kuellenberg/7-Segment-RGB-Clock/clock.png

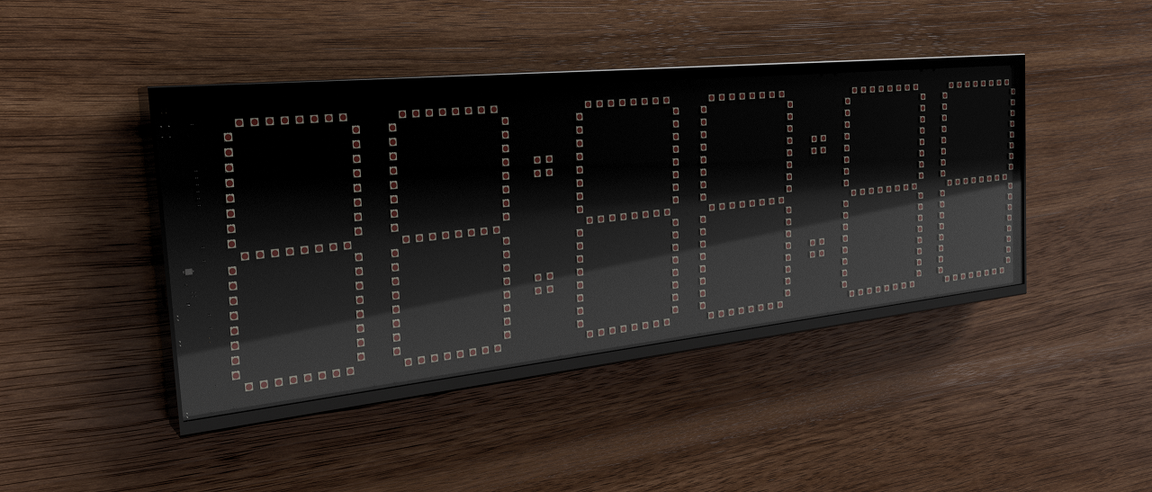
clock.png
