kuellenberg/7-Segment-RGB-Clock/Controller Rev. B/Room v2.png

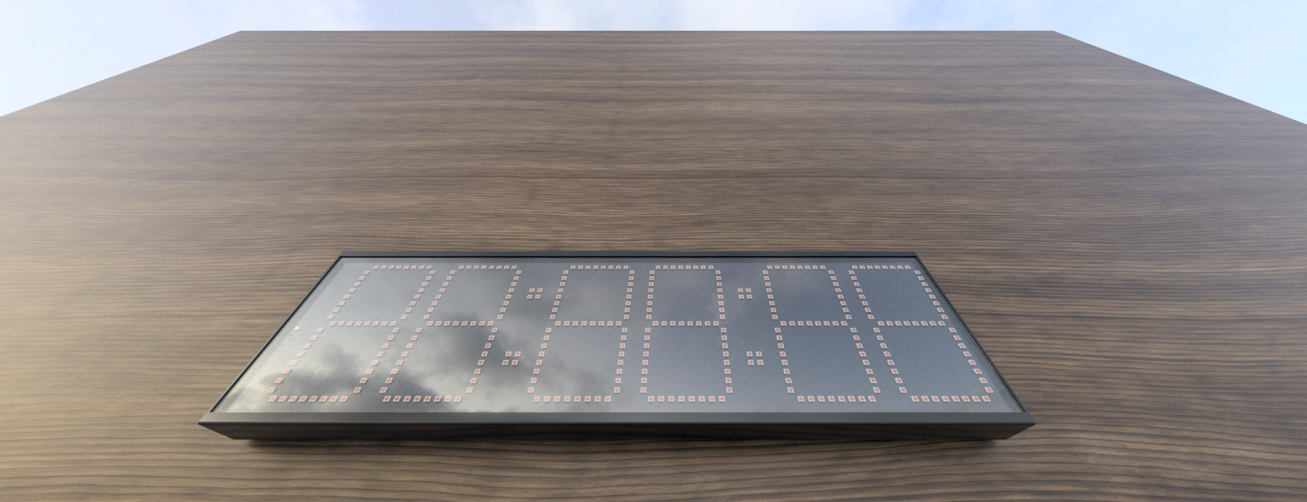
Controller Rev. B/Room v2.png
