kuellenberg/7-Segment-RGB-Clock/RS Components.xls

Order | Stückzahl | RS Components | Mouser | Herst.- Nr. | Hersteller | Beschreibung
y | 2 | 131-0271 |  | ATMEGA328P-AU | Microchip | 8-Bit Mikrocontroller - MCU 32KB In-system Flash 20MHz 1.8V-5.5V
y | 2 | 219-6096 |  | 0154001.DR | Littelfuse | Sicherungen zur Aufbaumontage Fuseblock w/ fuse 1A OMNI BLOK 154
y | 2 | 219-6125 |  | 0154004.DRT | Littelfuse | Sicherungen zur Aufbaumontage Fuseblock w/ fuse 4A OMNI BLOK 154T
n | 2 | 787-4218 |  | 1812L050PR | Littelfuse | Rückstellbare Sicherungen - PPTC 1812 15V .5A
n | 2 | 526-381 |  | SN74AHC1G14DBVR | Texas Instruments | Inverter Single Schmitt-Trgr
y | 4 | 715-1174 |  | UUR1A101MCL1GS | Nichicon | Alu-Elektrolytkondensatoren - SMD 10volts 100uF 20% AEC-Q200
y | 2 | 172-5271 |  | 61729-0011BLF | FCI / Amphenol | USB-Stecker USB
y | 2 | 740-8798 |  | RN73H1JTTD1000F100 | KOA Speer | Dünnfilmwiderstände - SMD 100Ohm,0603,1%,10ppm ,100mW,75V
y | 16 | 213-2266 |  | RN73H1JTTD1001F100 | KOA Speer | Dünnfilmwiderstände - SMD 1kOhm,0603,1%,10ppm, 100mW,75V
n | 8 | 679-0484 |  | RN73H1JTTD4701F100 | KOA Speer | Dünnfilmwiderstände - SMD 4.7kOhm,0603,1%,10pp m,100mW,75V
n | 4 | 678-9667 |  | RN73H1JTTD1002F50 | KOA Speer | Dünnfilmwiderstände - SMD 10kOhm,0603,1%,50ppm ,100mW,75V
y | 4 | 569-287 |  | EMVE250ADA331MJA0G | United Chemi-Con (UCC) | Alu-Elektrolytkondensatoren - SMD 25volts 330uF 10X10
y | 4 | 715-1433 |  | EEE-FK1K4R7P | Panasonic | Alu-Elektrolytkondensatoren - SMD 4.7UF 80V FK SMD
y | 2 | 191-3543 |  | DS3231M+TRL | Maxim Integrated | Echtzeituhr 5ppm, I C Real-Time Clock
y | 8 | 839-2950 |  | 885012206089 | Wurth Elektronik | Kondensator aus mehreren Keramikschichten MLCC - SMD/SMT WCAP-CSGP 0.01uF 0603 10% 50V MLCC
y | 2 | 181-4072 |  | 885012207092 | Wurth Elektronik | Kondensator aus mehreren Keramikschichten MLCC - SMD/SMT WCAP-CSGP 0.01uF 0805 10% 50V MLCC
y | 2 | 124-3361 |  | SFH 2440 | Osram Opto Semiconductor | Fotodioden PHOTODIODE
y | 2 | 180-7990 |  | SQ2309ES-T1_GE3 | Vishay | MOSFET 60V -1.7A 2W AEC-Q101 Qualified
y | 4 | 710-3339 |  | SI4435FDY-T1-GE3 | Vishay | MOSFET -30V Vds 20V Vgs SO-8
y | 2 | 135-6149 |  | FC0H105ZFTBR44-SS | KEMET | Superkondensatoren/Ultra-Kondensatoren 5.5V 1F -20/+80% Tape Width=44mm
y | 2 | 702-7305 | !!!!!!!!!!!!!! | CSTNE16M0V53Z000R0 | Murata | Resonatoren 16.0000MHz 15pF SMD CHP Resntr Wide Temp
y | 16 |  | 855-M20-8890845 | M20-8890845 | Harwin | Sockel & Kabelgehäuse 8 WAY SIL HORIZ SMT P/HDR
y | 10 | 692-0979 |  | LTST-C191KFKT | Lite-On | Standard-LEDs - SMD Orange Clear 605nm
y | 4 | 692-1051 |  | LTST-C193TBKT-5A | Lite-On | Standard-LEDs - SMD Blue 470nm 28mcd 20mA
y | 4 | 688-0492 |  | MBR130T1G | ON Semiconductor | Schottky Dioden & Gleichrichter 1A 30V
y | 2 | 406-580 |  | FT232RL-REEL | FTDI | USB-IC-Schnittstelle USB to Serial UART Enhanced IC SSOP-28
y | 2 |  | 926-LMV301MGX/NOPB | LMV301MGX/NOPB | Texas Instruments | Operationsverstärker
y | 6 | 724-2728 |  | LBR2012T100K | Taiyo Yuden | Festinduktivitäten 0805 10uH 468mOhms +/-10%Tol 150mA
n | 2 | 723-4972 |  | TMK107B7105MA-T | Taiyo Yuden | Kondensator aus mehreren Keramikschichten MLCC - SMD/SMT 0603 25V 1.0uF 20% X7R
n | 42 | 788-2985 |  | CGA3E2X7R1H104K080AA | TDK | Kondensator aus mehreren Keramikschichten MLCC - SMD/SMT CGA 0603 50V 0.1uF X7R 10% AEC-Q200
y | 12 | 788-3017 |  | GRM21BR71A106KA73K | Murata | Kondensator aus mehreren Keramikschichten MLCC - SMD/SMT 10UF 10V 10% 0805
y | 24 | 568-525 |  | EEE-HA1E331UP | Panasonic | Alu-Elektrolytkondensatoren - SMD 330UF 25V ELECT HA SMD
y | 12 | 171-4263 |  | SMAJ6.0CA | Bourns | ESD-Entstörer/TVS-Dioden 6volts 800/1600uA 38.8 Amps Bi-Dir
y | 24 | 187-1547 |  | AQ05C-01FTG | Littelfuse | ESD-Entstörer/TVS-Dioden 450W 5V BI AEC-Q101
y | 12 |  | 855-M20-7910842R | M20-7910842R | Harwin | Sockel & Kabelgehäuse 8 WAY SIL HORIZ SMT SKT T&R
y | 12 | 812-3353 |  | CRCW08050000Z0EAC | Vishay | Dickfilmwiderstände - SMD 1/8Watt 0ohms Commercial Use
y | 96 | 123-1691 |  | RT0805DRE071K58L | Yageo | Dünnfilmwiderstände - SMD
y | 12 |  | 595-TLC5952DAP | TLC5952DAP | Texas Instruments | LED-Anzeigetreiber 24-Channel Constant Current LED Drvr
y | 6 | 121-8344 |  | SN74LS244DWR | Texas Instruments | Puffer u. Leitungstreiber Tri-State Octal
y | 2 | 211-8030 |  | B57364S0509M000 |  | ntc
y | 1 | 493-2838 |  | Schurter 4300.5054
y | 1 | 533-4825 |  | Lumberg KFV 30
y | 1 | 533-6720 |  | Lumberg SV 30
y | 1 | 740-6155 |  | Lumberg WSV 30
y | 1 | 671-8978 |  |  |  | Ringkerntransformator, 80VA, Primär 230V ac / Sekundär 2 x 12V ac, 3.333A
y | 1 | 189-8189 |  | SK85-50-SA |  | Fischer Elektronik Kühlkörper 1.3K/W, 50mm x 160mm x 40mm, für Universelle rechteckige Alu
y | 1 | Conrad |  |  |  | Bopla ULTRAMAS UM 52011 L-50
