kuellenberg/7-Segment-RGB-Clock/BOM - Rev. A.xlsx

Sheet: Controller
Ref | Qnty | Spalte1 | Value | Cmp name | Footprint | Description | Mouser
C1, C2 | 2 | 4 | 330uF | CP_Small | Capacitor_SMD:CP_Elec_10x10 | Polarized capacitor, small symbol | …
C3 | 1 | 2 | 10nF | C_Small | Capacitor_SMD:C_0805_2012Metric | Unpolarized capacitor, small symbol | 710-885012207092
C4, C5 | 2 | 4 | 100uF | CP_Small | Capacitor_SMD:C_Elec_6.3x5.8 | Polarized capacitor, small symbol | 647-UUR1A101MCL1GS
C11, C9 | 2 | 4 | 4u7 | CP_Small | Capacitor_SMD:C_Elec_4x5.8 | Polarized capacitor, small symbol | 647-UUA1V4R7MCL1GS
C13, C20, C7, C8, C18, C15, C16, C12, C10 | 9 | 18 | 100nF | C_Small | Capacitor_SMD:C_0603_1608Metric | Unpolarized capacitor, small symbol | 810-CGA3E2X7R1H104K
C19, C23, C14, C17, C6 | 5 | 10 | 10nF | C_Small | Capacitor_SMD:C_0603_1608Metric | Unpolarized capacitor, small symbol | 710-885012206089
C22, C25, C21, C24 | 4 | 8 | 100n | C_Small | Capacitor_SMD:C_0603_1608Metric | Unpolarized capacitor, small symbol | …
C26 | 1 | 2 | 1F | CP | ak:FC0H105ZFTBR44 | Polarized capacitor | out of stock
D1, D2 | 2 | 4 | BLUE | LED | LED_SMD:LED_0603_1608Metric | Light emitting diode | 859-LTSTC193TBKT5A
D3, D9 | 2 | 4 | SS1P3L | D | Diode_SMD:D_SOD-123 | Diode | 863-MBR130T1G
D4 | 1 | 2 | ORANGE | LED | LED_SMD:LED_0603_1608Metric | Light emitting diode | 859-LTST-C191KFKT
D5 | 1 | 2 | GREEN | LED | LED_SMD:LED_0603_1608Metric | Light emitting diode | …
D6 | 1 | 2 | RX ORANGE | LED | LED_SMD:LED_0603_1608Metric | Light emitting diode | …
D7 | 1 | 2 | TX GREEN | LED | LED_SMD:LED_0603_1608Metric | Light emitting diode | 859-LTST-C190KGKT
D8 | 1 | 2 | RED | LED | LED_SMD:LED_0603_1608Metric | Light emitting diode | 859-LTST-C190KRKT
F1 | 1 | 2 | 4A | Fuse | ak:Fuseholder_SMD_Littelfuse_154 | Fuse | 576-0154004.DRT
F2 | 1 | 2 | 1A | Fuse | ak:Fuseholder_SMD_Littelfuse_154 | Fuse | 576-0154001.DR
F3 | 1 | 2 | 500mA | Polyfuse | Fuse:Fuse_1812_4532Metric | Resettable fuse, polymeric positive temperature coefficient | 576-1812L050PR
F4 | 1 | 2 | MF-MSMF050-2 500mA | Polyfuse | Fuse:Fuse_1812_4532Metric | Resettable fuse, polymeric positive temperature coefficient | …
J1 | 1 | 2 | CON_TLC | Conn_02x04_Odd_Even | ak:HARWIN_M20-8890845 | Generic connector, double row, 02x04, odd/even pin numbering scheme (row 1 odd numbers, row 2 even numbers), script generated (kicad-library-utils/schlib/autogen/connector/) | …
J2 | 1 | 2 | CON_15V | Conn_01x02 | Connector_JST:JST_XH_B2B-XH-A_1x02_P2.50mm_Vertical | Generic connector, single row, 01x02, script generated (kicad-library-utils/schlib/autogen/connector/) | …
J3 | 1 | 2 | CON_ICSP | Conn_02x03_Odd_Even | Connector_IDC:IDC-Header_2x03_P2.54mm_Vertical | Generic connector, double row, 02x03, odd/even pin numbering scheme (row 1 odd numbers, row 2 even numbers), script generated (kicad-library-utils/schlib/autogen/connector/) | …
J4 | 1 | 2 | DC out | Conn_02x04_Top_Bottom | ak:HARWIN_M20-8890845 | Generic connector, double row, 02x04, top/bottom pin numbering scheme (row 1: 1...pins_per_row, row2: pins_per_row+1 ... num_pins), script generated (kicad-library-utils/schlib/autogen/connector/) | …
J5 | 1 | 2 | CON_5V | Conn_01x02 | Connector_JST:JST_XH_B2B-XH-A_1x02_P2.50mm_Vertical | Generic connector, single row, 01x02, script generated (kicad-library-utils/schlib/autogen/connector/) | …
J6 | 1 | 2 | CON_5V_AUX | Conn_01x02 | Connector_JST:JST_XH_B2B-XH-A_1x02_P2.50mm_Vertical | Generic connector, single row, 01x02, script generated (kicad-library-utils/schlib/autogen/connector/) | …
J7 | 1 | 2 | CON_USB_A | USB_A | ak:UJ2-BV-1-TH | USB Type A connector | 530-SS-52300-002
L3, L2, L1 | 3 | 6 | 10uH | L_Small | Inductor_SMD:L_0805_2012Metric | Inductor, small symbol | 963-LBR2012T100K
Q1, Q2 | 2 | 4 | SI4435FDY | Q_PMOS_SSSGDDDD-ak | Package_SO:SO-8_5.3x6.2mm_P1.27mm |  | 78-SI4435FDY-T1-GE3
Q3 | 1 | 2 | SQ2309ES | Q_PMOS_GSD | Package_TO_SOT_SMD:SOT-23 | P-MOSFET transistor, gate/source/drain | SQ2309ES-T1_GE3
R5, R6, R7, R4, R3, R1, R2 | 7 | 14 | 1k | R_Small | Resistor_SMD:R_0603_1608Metric | Resistor, small symbol | 279-CRGP0603F1K0
R9, R8 | 2 | 4 | 4k7 | R_Small | Resistor_SMD:R_0603_1608Metric | Resistor, small symbol | 755-SFR03EZPF4701
R10 | 1 | 2 | LDR07 | LDR07 | OptoDevice:R_LDR_5.1x4.3mm_P3.4mm_Vertical | light dependent resistor | …
R12, R11 | 2 | 4 | 10k | R_Small | Resistor_SMD:R_0603_1608Metric | Resistor, small symbol | 603-RC0603FR-0710KL
R13 | 1 | 2 | 330R | R_Small | Resistor_SMD:R_0603_1608Metric | Resistor, small symbol | 71-CRCW0603330RFKEAC
R14 | 1 | 2 | 100R | R_Small | Resistor_SMD:R_0603_1608Metric | Resistor, small symbol | 603-AC0603FR-13100RL
R15 | 1 | 2 | 47k | R_Small | Resistor_SMD:R_0603_1608Metric | Resistor, small symbol | 71-CRCW060347K0FKEAC
SW1 | 1 | 2 | SW_Push | SW_Push | Button_Switch_THT:SW_PUSH_6mm | Push button switch, generic, two pins | …
U1 | 1 | 2 | FT232RL | FT232RL | Package_SO:SSOP-28_5.3x10.2mm_P0.65mm | USB to Serial Interface, SSOP-28 | 895-FT232RL
U2 | 1 | 2 | ATmega328P-AU | ATmega328P-AU-ak | Package_QFP:TQFP-32_7x7mm_P0.8mm |  | 556-ATMEGA328P-AU
U3 | 1 | 2 | DS3231M | DS3231M | Package_SO:SOIC-16W_7.5x10.3mm_P1.27mm | Extremely Accurate I2C-Integrated RTC/TCXO/Crystal SOIC-16 | 700-DS3231M+TRL
U4 | 1 | 2 | 74AHC1G14 | 74AHC1G14 | Package_TO_SOT_SMD:SOT-23-5 |  | 595-SN74AHC1G14DBVR
U5 | 1 | 2 | MCP6001-OT | MCP6001-OT | Package_TO_SOT_SMD:SOT-23-5 | 1MHz, Low-Power Op Amp, SOT-23-5 | 579-MCP6001T-I/OT
U6 | 1 | 2 | MCP4012-xxxxCH | MCP4012-xxxxCH | Package_TO_SOT_SMD:SOT-23-6 | Low-Cost 64-Step Volatile Digital Potentiometer | 579-MCP4012T-503E/CH
Y1 | 1 | 2 | 16MHz | Resonator_Small | ak:CSTNE | Three pin ceramic resonator, small symbol | 81-CSTNE16M0V53Z000R

Sheet: Digit+Colon
Ref | Qnty | Spalte1 | Value | Cmp name | Footprint | Description | Mouser
C1, C2, C7, C10, C11, C9, C8 | 7 | 91 | 100n | C_Small | Capacitor_SMD:C_0805_2012Metric | Unpolarized capacitor, small symbol | 810-CGA3E2X7R1H104K
C4, C3, C5, C6 | 4 | 52 | 330uF | CP_Small | Capacitor_SMD:C_Elec_8x10.2 | Polarized capacitor, small symbol | 667-EEE-HA1E331UP
C12, C13 | 2 | 26 | 10uF | C_Small | Capacitor_SMD:C_0805_2012Metric | Unpolarized capacitor, small symbol
D25, D26, D27, D28, D48, D47, D46, D45, D40, D39, D38, D37, D32, D31, D30, D24, D23, D22, D21, D16, D15, D14, D13, D8, D7, D6, D5, D29, D4, D3, D2, D1, D36, D35, D34, D33, D53, D54, D55, D56, D41, D42, D43, D44, D12, D11, D10, D9, D20, D19, D18, D17, D52, D51, D50, D49, D70, D68, D66, D64, D69, D67, D65, D63 | 64 | 832 | LED_RGB | LED_BGR | LED_SMD:LED_RGB_5050-6 | RGB LED, 6 pin package
D57, D62 | 2 | 26 | D_TVS | D_TVS | Diode_SMD:D_SMA | Bidirectional transient-voltage-suppression diode
D60, D61, D59, D58 | 4 | 52 | 5V | D_TVS | Diode_SMD:D_SOD-323 | Bidirectional transient-voltage-suppression diode
J1 | 1 | 13 | DC IN | Conn_02x04_Top_Bottom | ak:HARWIN_M20-8890845 | Generic connector, double row, 02x04, top/bottom pin numbering scheme (row 1: 1...pins_per_row, row2: pins_per_row+1 ... num_pins), script generated (kicad-library-utils/schlib/autogen/connector/)
J2 | 1 | 13 | DC OUT | Conn_02x04_Top_Bottom | ak:HARWIN_M20-7910842R | Generic connector, double row, 02x04, top/bottom pin numbering scheme (row 1: 1...pins_per_row, row2: pins_per_row+1 ... num_pins), script generated (kicad-library-utils/schlib/autogen/connector/)
J3 | 1 | 13 | Signal in | Conn_02x04_Odd_Even | ak:HARWIN_M20-7910842R | Generic connector, double row, 02x04, odd/even pin numbering scheme (row 1 odd numbers, row 2 even numbers), script generated (kicad-library-utils/schlib/autogen/connector/)
J4 | 1 | 13 | Signal out | Conn_02x04_Odd_Even | ak:HARWIN_M20-8890845 | Generic connector, double row, 02x04, odd/even pin numbering scheme (row 1 odd numbers, row 2 even numbers), script generated (kicad-library-utils/schlib/autogen/connector/)
JP1, JP2, JP3, JP4 | 4 | 52 | SolderJumper_2_Open | SolderJumper_2_Open | Jumper:SolderJumper-2_P1.3mm_Open_TrianglePad1.0x1.5mm | Solder Jumper, 2-pole, open
R1, R2, R3, R4, R5, R6, R7, R8, R9, R10, R12, R13, R14, R15, R16, R11, R18, R17 | 18 | 234 | TBD | R_Small | Resistor_SMD:R_0805_2012Metric | Resistor, small symbol | 652-CR0805FX-56R0ELF
U1, U2 | 2 | 26 | TLC5952 | TLC5952 | Package_SO:HTSSOP-32-1EP_6.1x11mm_P0.65mm_EP5.2x11mm_Mask4.11x4.36mm_ThermalVias
U3 | 1 | 13 | 74LS244 | 74LS244 | Package_SO:SO-20_12.8x7.5mm_P1.27mm | 8-bit Bus Buffer 3-State outputs
