kuellenberg/7-Segment-RGB-Clock/Datasheets/Arduino Nano 3.1 BOM.xlsx

 |  | Arduino Nano |  |  |  | v3.1
Item | Quantity | Reference | Part | Mfg P/N | Size | P/N | Feeder LOC | Feeder LOC F/O
1 | 5 | C1,C3,C4,C7,C9 | CAP 0.1uF +/- 5% 50V Ceramic | 08055C104KAT2A | 0805 | C601 (51045) | R12 | F32
2 | 1 | C2 | CAP CERAMIC 10UF 16V -20% +80% Y5V | 08055C104KAT2A | 1206 | C553 (10601) | F32 | F41
3 | 1 | D1 | Diode, Schottky 0.5A 20V | MBR0520LT1G | SOD-123 | C107 (15201) | F41 | F36
4 | 1 | J1,J2 | Headers, 36PS 1 Row |  | PTH
5 | 1 | J4 | Connector, Mini-B Recept Rt. Angle
6 | 1 | J5 | Headers, 72PS 2 Rows |  | PTH
7 | 1 | LD1 | LED, RED 20mA 624nm 42mcd 140deg | EC04-0805QRC/E-AV | 0805 | C101 (2016) | F34 | F34
8 | 1 | LD2 | LED, GREEN 2.1V 20mA 571nm 10mcd 140deg | 17-21SYGC/S530-E2/TR8 | 0805 | C102 (2013) | F35 | F35
9 | 1 | LD3 | LED, YELLOW 2.0V 20mA 589nm 43mcd 140deg | 0805UYC/E-AV | 0805 | C103 (2014) | F31 | F31
10 | 1 | LD4 | LED, Super Bright BLUE 80mcd 470nm 110degree | 17-21SUBHC/S530-A2/TR8 | 0805 | C100 (2015) | F30 | F30
11 | 1 | R1 | Resistor Pack, 1K +/-5% 62.5mW 4RES SMD | YC164-JR-071KL |  | C108 (16407) | F37 | F37
12 | 1 | R2 | Resistor Pack, 680 +/-5% 62.5mW 4RES SMD | YC164-JR-07680RL |  | C109 (16408) | F45 | F35
13 | 1 | SW1 | Switch, Momentary Tact SPST 150gf 3.0x2.5mm | SKRKAEE010
14 | 1 | U1 | IC, Microcontroller ATMEGA328 RISC 32kB Flash, 0.5kB EEPROM, 23 I/O Pins | ATMEGA328P-AUR
15 | 1 | U2 | IC, USB to SERIAL UART | FT232RL-REEL | SSOP-28 | C104 (32820) | F35 | F44
16 | 1 | U3 | IC, Voltage regulator 5V, 500mA | UA78M05CDCYR | SOT-223 | C110 (28232) | F43 | F39
17 | 1 | Y1 | Cystal, 16MHz 0.5% | CSTCE16M0V53-R0 |  | C111 (16053) | F38 | F38
18 | 1 | C5 | CAP CER 4.7UF 10V Y5V 0603 | GRM188F51A475ZE20D | 0603 | C209 | R13 | F33
19 | 1 | F1 | FUSE PTC RESET 500MA SMD 0603 | MF-FSMF050X-2 | 0603 | C208 | R16 | F31
