kuellenberg/7-Segment-RGB-Clock/Bracket/Bracket.step

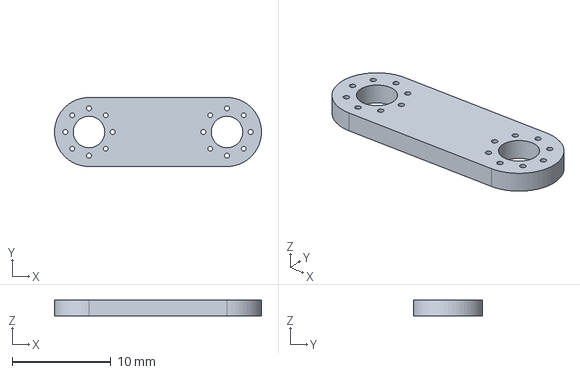
[picture p3: CAD file, 2019-10-04]
Bracket/Bracket.step
21.0 x 7.00 x 1.60 mm
