kuellenberg/7-Segment-RGB-Clock/Power_Supply Rev. A/backplate.dxf

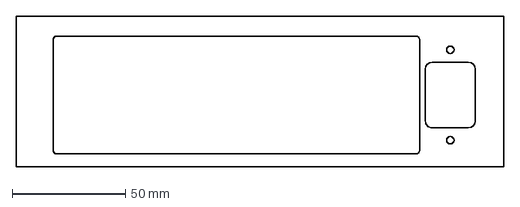
[picture p4: CAD file, 2020-07-28]
Power_Supply Rev. A/backplate.dxf
215.6 x 66.4 mm
