kuellenberg/7-Segment-RGB-Clock/Power_Supply/platine.dxf

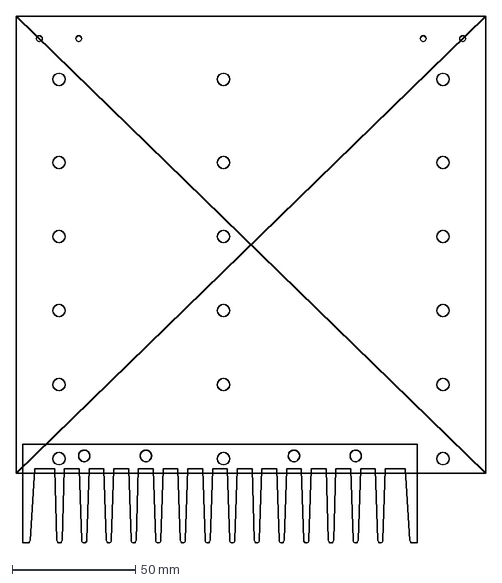
[picture p5: CAD file, 2020-07-15]
Power_Supply/platine.dxf
190.2 x 213.4 mm
