kuellenberg/7-Segment-RGB-Clock/Power_Supply Rev. A/frontplate.dxf

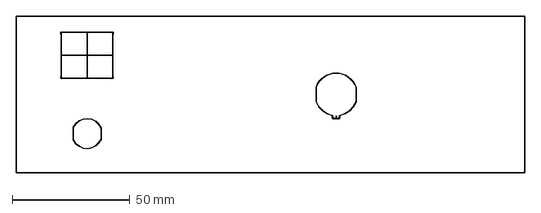
[picture p6: CAD file, 2020-07-28]
Power_Supply Rev. A/frontplate.dxf
215.6 x 66.4 mm
