kuellenberg/7-Segment-RGB-Clock/Power_Supply Rev. A/ltspice/555.asc

C1: cap; 100n
C2: cap; 10µ
C3: cap; 100n
Q1: pnp; BC556B
R1: res; 100k
R2: res; 600
R4: res; 100k
U1: NE555
V1: voltage; PULSE(0 12 0 1m 1m 5 5.1 3)
Named nets: 0
.tran 20 startup
