kuellenberg/7-Segment-RGB-Clock/Power_Supply Rev. A/ltspice/trafo.asc

C1: cap; 4700µ; Rser=0.124
C3: cap; 4700µ; Rser=0.124
D1: diode; RR601BM4S
D2: diode; RR601BM4S
D3: diode; RR601BM4S
D4: diode; RR601BM4S
I1: current; 2.5
V1: voltage; SINE(0 19 50); Rser=0.2
Named nets: 0, a, b, c
.tran 1
https://de.rs-online.com/web/p/ringkern-transformatoren/6718978/
;.step I1 0.5 2.5 0.5
