kuellenberg/7-Segment-RGB-Clock/Controller Rev. B/Controller.kicad_pcb

## KiCad design Controller Rev. B/Controller.kicad_pcb (2021-01-15)

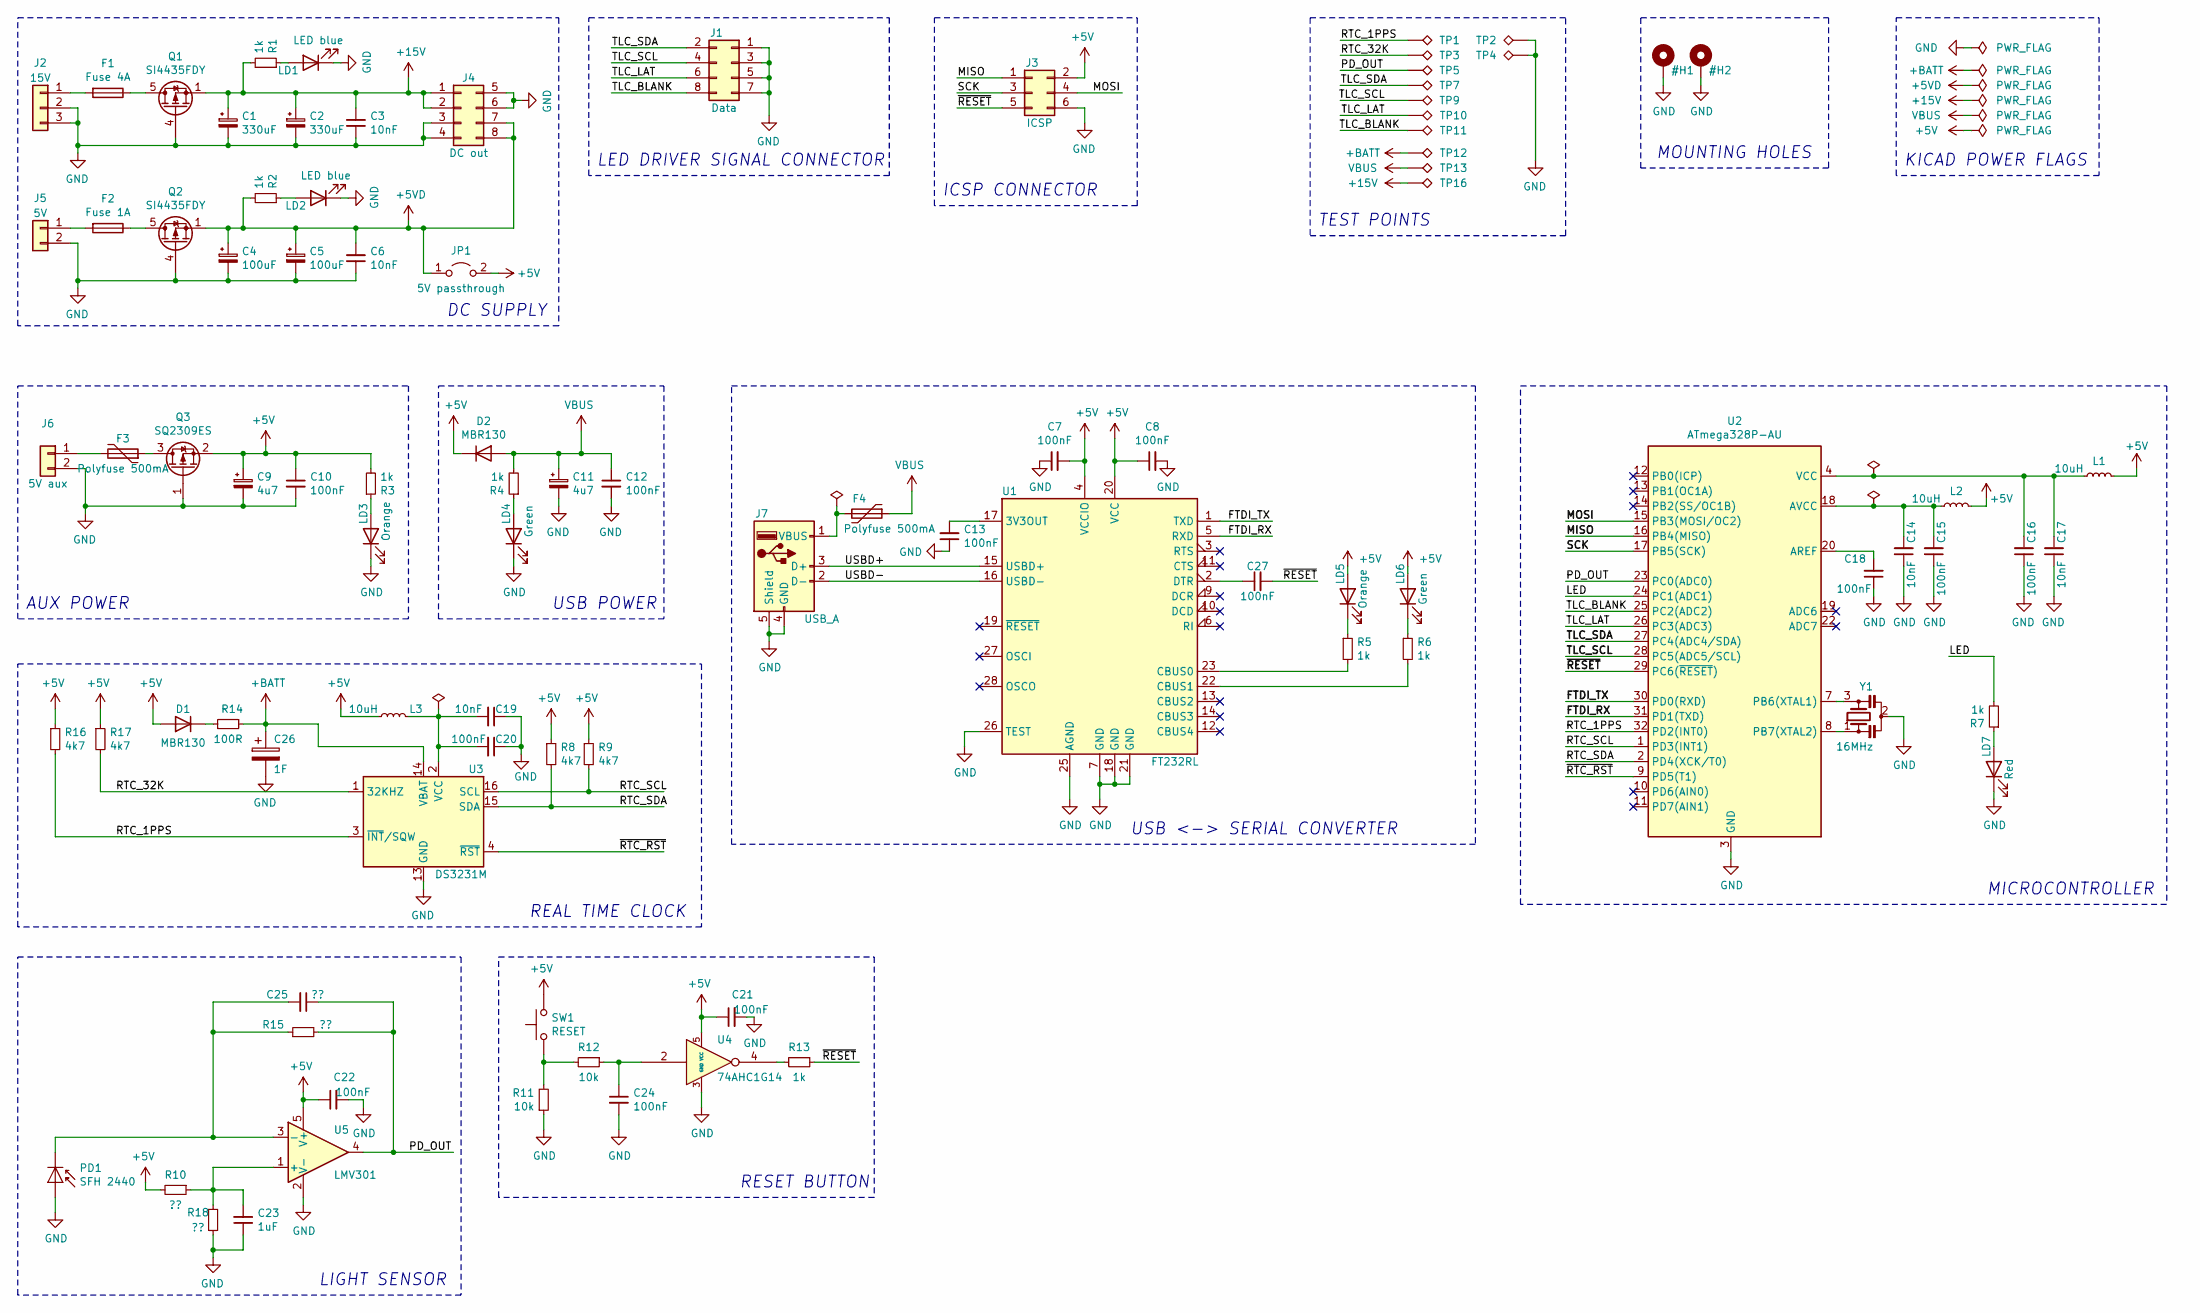
[picture p7: schematic Controller.sch]

Parts:
C1, C2: 330uF; CP_Elec_10x10; Mouser 661-EMVE250ADA331MJA
C3: 10nF; C_0805_2012Metric; Mouser 710-885012207092
C4, C5: 100uF; C_Elec_6.3x5.8; Mouser 647-UUR1A101MCL1GS
C6, C14, C17, C19: 10nF; C_0603_1608Metric; Mouser 710-885012206089
C7, C8, C10, C12, C13, C15, C16, C18, C20, C21, C22, C24, C27: 100nF; C_0603_1608Metric; Mouser 576-1812L050PR
C9, C11: 4u7; C_Elec_4x5.8; Mouser 667-EEE-FK1K4R7P
C23: 1uF; C_0603_1608Metric; Mouser 963-TMK107B7105MA-T
C25: ??; C_0603_1608Metric
C26: 1F; FC0H105ZFTBR44; Mouser 80-FC0H105ZFTBR44-SS
D1, D2: MBR130; D_SOD-123; Mouser 863-MBR130T1G
F1: Fuse 4A; Fuseholder_SMD_Littelfuse_154; Mouser 576-0154004.DRT
F2: Fuse 1A; Fuseholder_SMD_Littelfuse_154; Mouser 576-0154001.DR
F3, F4: Polyfuse 500mA; Fuse_1812_4532Metric; Mouser 576-1812L050PR
J1, J4: Conn_02x04_Top_Bottom; HARWIN_M20-8890845; Mouser 855-M20-8890845
J2: 15V; JST_XH_B03B-XH-A_03x2.50mm_Straight; Digikey 455-2248-ND
J3: Conn_02x03_Top_Bottom; IDC-Header_2x03_P2.54mm_Vertical; Digikey 732-5394-ND
J5: 5V; JST_XH_B2B-XH-A_1x02_P2.50mm_Vertical; Digikey 455-2247-ND
J6: Conn_01x02; JST_XH_B2B-XH-A_1x02_P2.50mm_Vertical; Digikey 455-2247-ND
J7: USB_A; USB_B_OST_USB-B1HSxx_Horizontal; Mouser 649-61729-0011BLF
JP1: Jumper; PinSocket_1x02_P2.54mm_Vertical; Digikey S1012EC-02-ND
L1, L2, L3: 10uH; L_0805_2012Metric; Mouser 963-LBR2012T100K
LD1, LD2: LED blue; LED_0603_1608Metric; Mouser 859-LTSTC193TBKT5A
LD3, LD5: LED; LED_0603_1608Metric; Mouser 859-LTST-C191KFKT
LD4, LD6: LED; LED_0603_1608Metric; Mouser 859-LTST-C190KGKT
LD7: LED; LED_0603_1608Metric; Mouser 859-LTST-C190KRKT
PD1: SFH 2440; Osram_SMD-DIL2_4.5x4.0mm; Mouser 720-SFH2440
Q1, Q2: SI4435FDY; SO-8_5.3x6.2mm_P1.27mm; Mouser 78-SI4435FDY-T1-GE3
Q3: SQ2309ES; SOT-23; Mouser 781-SQ2309ES-T1_GE3
R1, R2, R3, R4, R5, R6, R7, R13: 1k; R_0603_1608Metric; Mouser 660-RN73H1JT1001F100
R8, R9, R16, R17: 4k7; R_0603_1608Metric; Mouser 660-RN73H1JT4701F100
R10, R15, R18: ??; R_0603_1608Metric
R11, R12: 10k; R_0603_1608Metric; Mouser 660-RN73H1JTD1002F50
R14: 100R; R_0603_1608Metric; Mouser 660-RN73H1JT1000F100
SW1: RESET; SW_PUSH_6mm
TP1: RTC_1PPS; TestPoint_Pad_D2.0mm
TP2, TP4: GND; TestPoint_Loop_D2.60mm_Drill1.6mm_Beaded
TP3: RTC_32K; TestPoint_Pad_D2.0mm
TP5: PD_OUT; TestPoint_Pad_D2.0mm
TP7: TLC_SDA; TestPoint_Pad_D2.0mm
TP9: TLC_SCL; TestPoint_Pad_D2.0mm
TP10: TLC_LAT; TestPoint_Pad_D2.0mm
TP11: TLC_BLANK; TestPoint_Pad_D2.0mm
TP12: +BATT; TestPoint_Pad_D2.0mm
TP13: VBUS; TestPoint_Pad_D2.0mm
TP16: +15V; TestPoint_Pad_D2.0mm
U1: FT232RL; SSOP-28_5.3x10.2mm_P0.65mm; Mouser 895-FT232RL
U2: ATmega328P-AU; TQFP-32_7x7mm_P0.8mm; Mouser 556-ATMEGA328P-AU
U3: DS3231M; SOIC-16W_7.5x10.3mm_P1.27mm; Mouser 700-DS3231M+TRL
U4: 74AHC1G14; SOT-23-5; Mouser 595-SN74AHC1G14DBVR
U5: LMV301; SOT-353_SC-70-5; Mouser 926-LMV301MGX/NOPB
Y1: 16MHz; CSTNE; Mouser 81-CSTNE16M0V53Z000R

Connections:
+5V: C7.2, C8.1, C9.1, C10.1, C21.1, C22.1, D1.2 (A), D2.1 (K), J3.2, JP1.2 (B), L1.2, L2.2, L3.1, LD5.2 (A), LD6.2 (A), Q3.2 (S), R3.2, R8.1, R9.1, R10.2, R16.1, R17.1, SW1.2, U1.4 (VCCIO), U1.20 (VCC), U4.5 (VCC), U5.5 (V+)
+5VD: C4.1, C5.1, C6.2, J4.7, J4.8, JP1.1 (A), Q2.1 (S), Q2.2 (S), Q2.3 (S), R2.2
+15V: C1.1, C2.1, C3.2, J4.1, J4.2, Q1.1 (S), Q1.2 (S), Q1.3 (S), R1.2, TP16.1
+BATT: C26.1, R14.1, TP12.1, U3.14 (VBAT)
/FTDI_RX: U1.5 (RXD), U2.31 (PD1(TXD))
/FTDI_TX: U1.1 (TXD), U2.30 (PD0(RXD))
/LED: R7.2, U2.24 (PC1(ADC1))
/MISO: J3.1, U2.16 (PB4(MISO))
/MOSI: J3.4, U2.15 (PB3(MOSI/OC2))
/PD_OUT: C25.1, R15.2, TP5.1, U2.23 (PC0(ADC0)), U5.4
/RTC_1PPS: R16.2, TP1.1, U2.32 (PD2(INT0)), U3.3 (~INT~/SQW)
/RTC_32K: R17.2, TP3.1, U3.1 (32KHZ)
/RTC_SCL: R9.2, U2.1 (PD3(INT1)), U3.16 (SCL)
/RTC_SDA: R8.2, U2.2 (PD4(XCK/T0)), U3.15 (SDA)
/SCK: J3.3, U2.17 (PB5(SCK))
/TLC_BLANK: J1.8, TP11.1, U2.25 (PC2(ADC2))
/TLC_LAT: J1.6, TP10.1, U2.26 (PC3(ADC3))
/TLC_SCL: J1.4, TP9.1, U2.28 (PC5(ADC5/SCL))
/TLC_SDA: J1.2, TP7.1, U2.27 (PC4(ADC4/SDA))
/USBD+: J7.3 (D+), U1.15 (USBD+)
/USBD-: J7.2 (D-), U1.16 (USBD-)
/~RESET~: C27.2, J3.5, R13.1, U2.29 (PC6(~RESET~))
/~RTC_RST~: U2.9 (PD5(T1)), U3.4 (~RST)
GND: C1.2, C2.2, C3.1, C4.2, C5.2, C6.1, C7.1, C8.2, C9.2, C10.2, C11.2, C12.2, C13.1, C14.1, C15.1, C16.1, C17.1, C18.1, C19.1, C20.1, C21.2, C22.2, C23.1, C24.2, C26.2, J1.1, J1.3, J1.5, J1.7, J2.2, J2.3, J3.6, J4.3, J4.4, J4.5, J4.6, J5.2, J6.2, J7.4 (GND), J7.5 (Shield), LD1.1 (K), LD2.1 (K), LD3.1 (K), LD4.1 (K), LD7.1 (K), PD1.2 (A), Q1.4 (G), Q2.4 (G), Q3.1 (G), R11.1, R18.2, TP2.1, TP4.1, U1.7 (GND), U1.18 (GND), U1.21 (GND), U1.25 (AGND), U1.26 (TEST), U2.3 (GND), U2.5 (GND), U2.21 (GND), U3.5 (GND), U3.6 (GND), U3.7 (GND), U3.8 (GND), U3.9 (GND), U3.10 (GND), U3.11 (GND), U3.12 (GND), U3.13 (GND), U4.3 (GND), U5.2 (V-), Y1.2; also elsewhere on the board
unnamed: C13.2, U1.17 (3V3OUT)
unnamed: C14.2, C15.2, L2.1, U2.18 (AVCC)
unnamed: C16.2, C17.2, L1.1, U2.4 (VCC), U2.6 (VCC)
unnamed: C18.2, U2.20 (AREF)
unnamed: C19.2, C20.2, L3.2, U3.2 (VCC)
unnamed: C23.2, R10.1, R18.1, U5.1 (+)
unnamed: C24.1, R12.1, U4.2
unnamed: C25.2, PD1.1 (K), R15.1, U5.3 (-)
unnamed: C27.1, U1.2 (DTR)
unnamed: D1.1 (K), R14.2
unnamed: F1.1, Q1.5 (D), Q1.6 (D), Q1.7 (D), Q1.8 (D)
unnamed: F1.2, J2.1
unnamed: F2.1, Q2.5 (D), Q2.6 (D), Q2.7 (D), Q2.8 (D)
unnamed: F2.2, J5.1
unnamed: F3.1, Q3.3 (D)
unnamed: F3.2, J6.1
unnamed: F4.2, J7.1 (VBUS)
unnamed: LD1.2 (A), R1.1
unnamed: LD2.2 (A), R2.1
unnamed: LD3.2 (A), R3.1
unnamed: LD4.2 (A), R4.1
unnamed: LD5.1 (K), R5.1
unnamed: LD6.1 (K), R6.1
unnamed: LD7.2 (A), R7.1
unnamed: R5.2, U1.23 (CBUS0)
unnamed: R6.2, U1.22 (CBUS1)
unnamed: R11.2, R12.2, SW1.1
unnamed: R13.2, U4.4
unnamed: U2.7 (PB6(XTAL1)), Y1.3
unnamed: U2.8 (PB7(XTAL2)), Y1.1
VBUS: C11.1, C12.1, D2.2 (A), F4.1, R4.2, TP13.1

Notes on the sheet:
REAL TIME CLOCK
USB <-> SERIAL CONVERTER
MICROCONTROLLER
ICSP CONNECTOR
USB POWER
MOUNTING HOLES
AUX POWER
DC SUPPLY
LED DRIVER SIGNAL CONNECTOR
TEST POINTS
KICAD POWER FLAGS
RESET BUTTON
LIGHT SENSOR

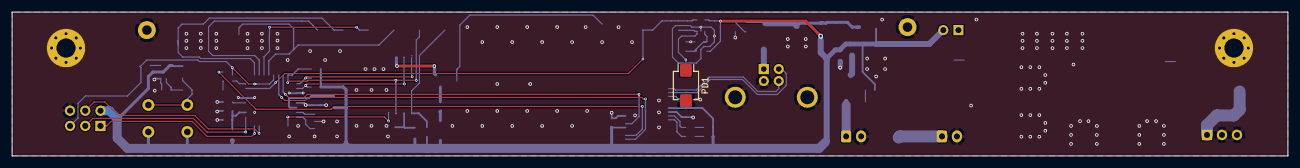
[picture p8: board Controller.kicad_pcb from above]

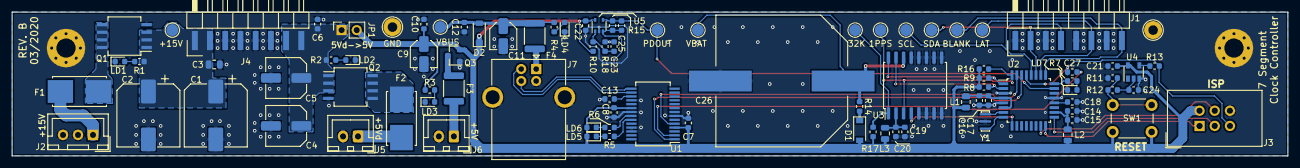
[picture p9: board Controller.kicad_pcb from below]

Board: 2 copper layers, 213.0 x 24.0 mm, 94 parts (91 on the bottom side), 55 nets.

Other parts of the board:
H1, H2: Mounting Hole; MountingHole_3.2mm_M3_Pad_Via

Their connections:
GND: H1.1, H2.1; also elsewhere on the board
