kuellenberg/7-Segment-RGB-Clock/Power_Supply Rev. A/Power supply.kicad_pcb

## KiCad design Power_Supply Rev. A/Power supply.kicad_pcb (2020-08-10)

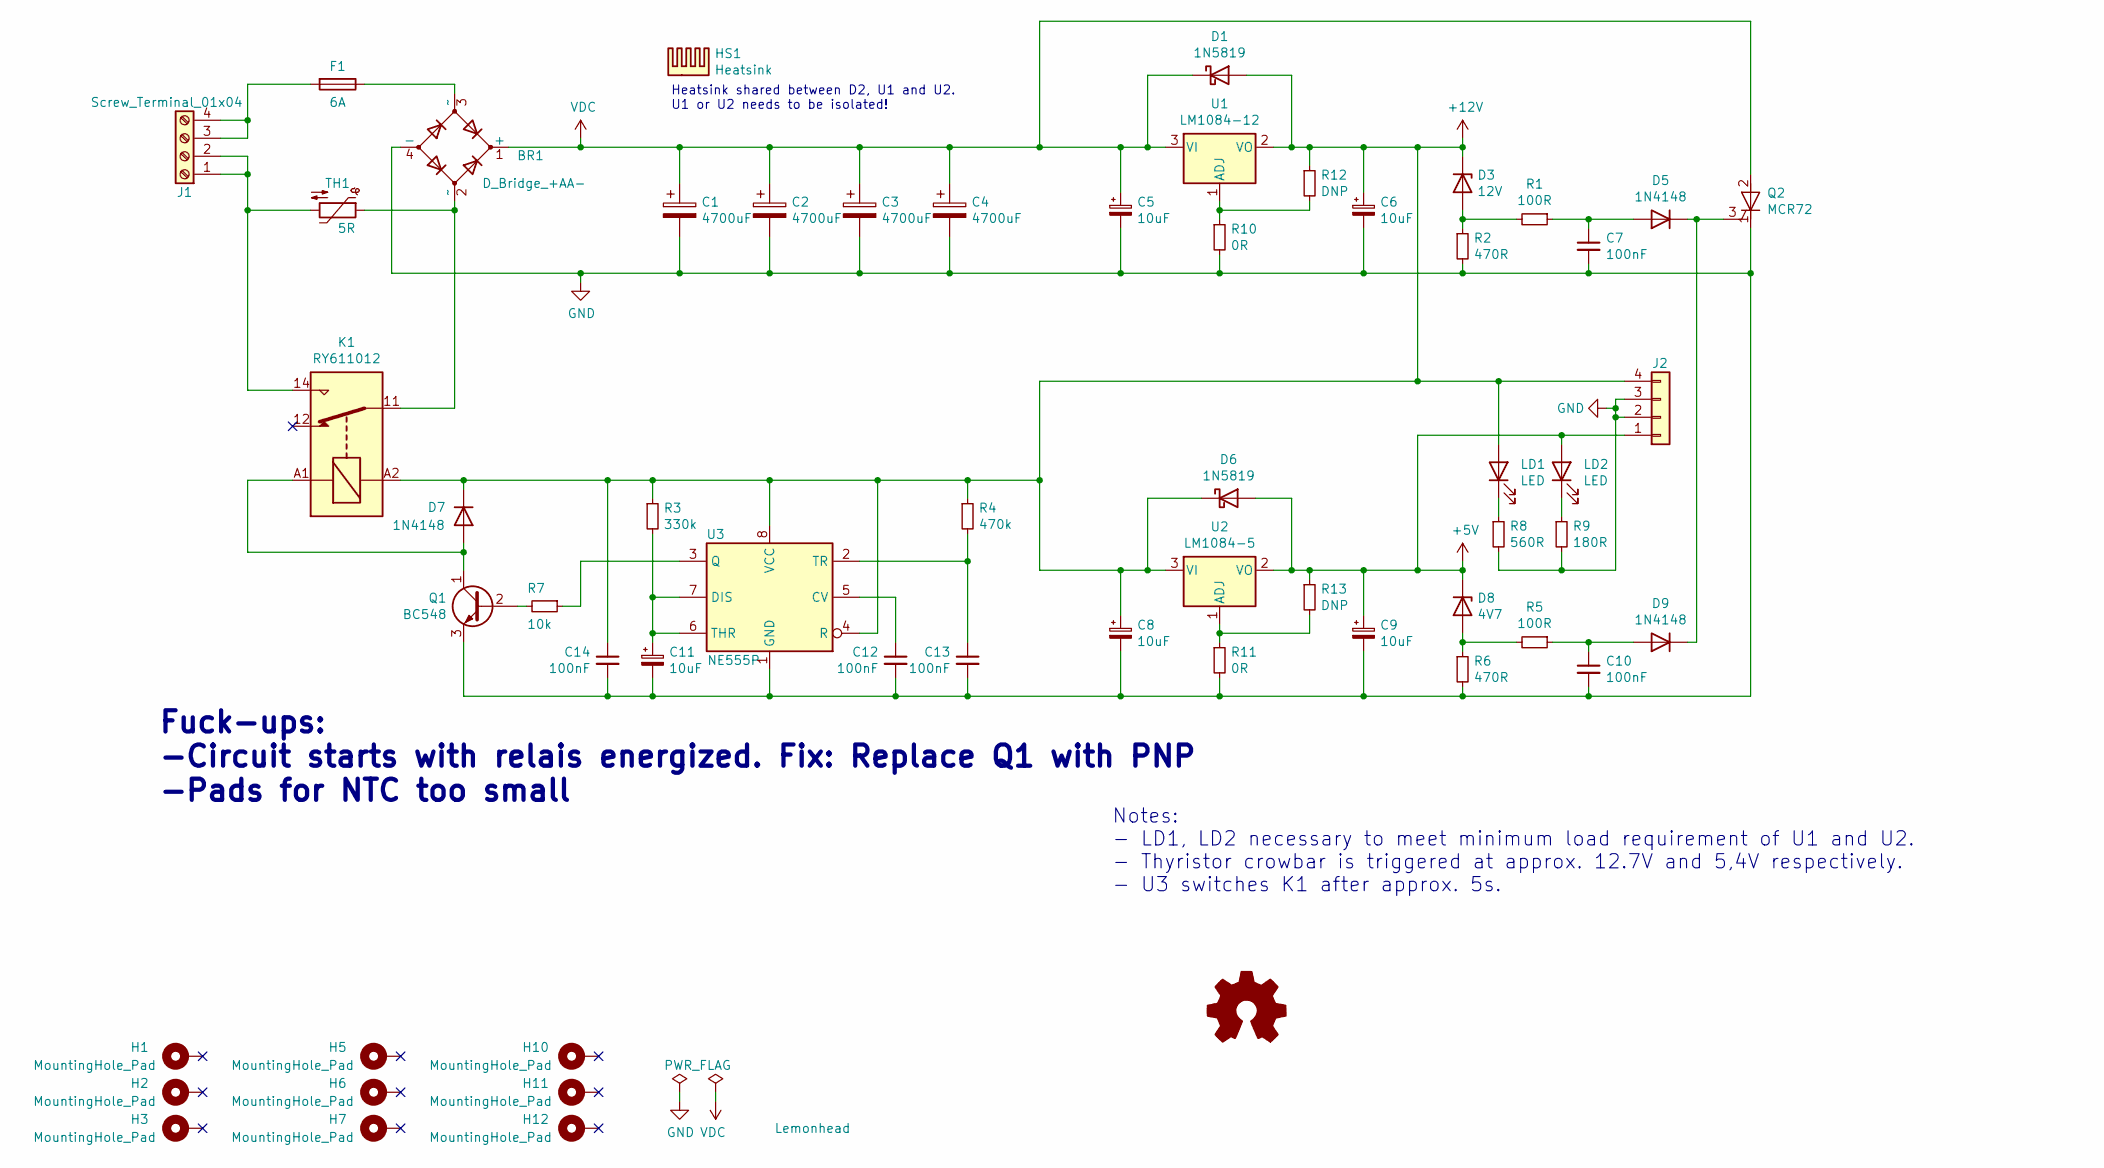
[picture p10: schematic Power supply.sch, Linear Power Supply for 7 Segment RGB Clock]

Parts:
BR1: D_Bridge_+AA-; GBJ
C1, C2, C3, C4: 4700uF; CP_Radial_D25.0mm_P10.00mm_SnapIn
C5, C6, C8, C9, C11: 10uF; CP_Radial_D5.0mm_P2.00mm
C7, C10, C12, C13, C14: 100nF; C_Disc_D5.0mm_W2.5mm_P2.50mm
D1, D6: 1N5819; D_DO-41_SOD81_P10.16mm_Horizontal
D3: 12V; D_DO-35_SOD27_P10.16mm_Horizontal
D5, D9: 1N4148; D_DO-35_SOD27_P10.16mm_Horizontal
D7: 1N4148; D_DO-35_SOD27_P7.62mm_Horizontal
D8: 4V7; D_DO-35_SOD27_P10.16mm_Horizontal
F1: 6A; Fuseholder_Cylinder-6.3x32mm_Schurter_0031-8002_Horizontal_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
H1, H2, H3, H5, H6, H7: MountingHole_Pad; MountingHole_3.2mm_M3_Pad
H10, H11: MountingHole_Pad; MountingHole_4.3mm_M4_Pad
H12: MountingHole_Pad; MountingHole_5.3mm_M5_Pad
HS1: Heatsink; HS-160x50
J1: Screw_Terminal_01x04; TerminalBlock_RND_205-00003_1x04_P5.00mm_Horizontal
J2: Conn_01x04; Molex_KK-396_A-41791-0004_1x04_P3.96mm_Vertical
K1: RY611012
LD1, LD2: LED; LED_D5.0mm
LOGO1: Lemonhead; lemonhead
Q1: BC548; TO-92_Inline
Q2: MCR72; TO-220F-3_Horizontal_TabDown
R1, R5: 100R; R_Axial_DIN0207_L6.3mm_D2.5mm_P10.16mm_Horizontal
R2, R6: 470R; R_Axial_DIN0207_L6.3mm_D2.5mm_P10.16mm_Horizontal
R3: 330k; R_Axial_DIN0207_L6.3mm_D2.5mm_P10.16mm_Horizontal
R4: 470k; R_Axial_DIN0207_L6.3mm_D2.5mm_P10.16mm_Horizontal
R7: 10k; R_Axial_DIN0207_L6.3mm_D2.5mm_P10.16mm_Horizontal
R8: 560R; R_Axial_DIN0207_L6.3mm_D2.5mm_P10.16mm_Horizontal
R9: 180R; R_Axial_DIN0207_L6.3mm_D2.5mm_P10.16mm_Horizontal
R10, R11: 0R; R_Axial_DIN0207_L6.3mm_D2.5mm_P10.16mm_Horizontal
R12, R13: DNP; R_Axial_DIN0207_L6.3mm_D2.5mm_P10.16mm_Horizontal
TH1: 5R; RV_Disc_D21.5mm_W6.1mm_P7.5mm
U1: LM1084-12; TO-220-3_Vertical
U2: LM1084-5; TO-220-3_Vertical
U3: NE555P; DIP-8_W7.62mm

Connections:
+5V: C9.1, D6.2 (A), D8.1 (K), J2.1, LD2.2 (A), R13.1, U2.2 (VO)
+12V: C6.1, C8.1, C14.1, D1.2 (A), D3.1 (K), D6.1 (K), D7.1 (K), J2.4, K1.A2, LD1.2 (A), R3.1, R4.1, R12.1, U1.2 (VO), U2.3 (VI), U3.4 (R), U3.8 (VCC)
GND: BR1.4 (-), C1.2, C2.2, C3.2, C4.2, C5.2, C6.2, C7.2, C8.2, C9.2, C10.2, C11.2, C12.2, C13.2, C14.2, J2.2, J2.3, Q1.3 (E), Q2.1 (K), R2.2, R6.2, R8.2, R9.2, R10.2, R11.2, U3.1 (GND)
unnamed: BR1.2 (~~), K1.11, TH1.1
unnamed: BR1.3 (~~), F1.1
unnamed: C7.1, D5.2 (A), R1.1
unnamed: C10.1, D9.2 (A), R5.1
unnamed: C11.1, R3.2, U3.6 (THR), U3.7 (DIS)
unnamed: C12.1, U3.5 (CV)
unnamed: C13.1, R4.2, U3.2 (TR)
unnamed: D3.2 (A), R1.2, R2.1
unnamed: D5.1 (K), D9.1 (K), Q2.3 (G)
unnamed: D7.2 (A), K1.A1, Q1.1 (C)
unnamed: D8.2 (A), R5.2, R6.1
unnamed: F1.2, J1.3, J1.4
unnamed: J1.1, J1.2, K1.14, TH1.2
unnamed: LD1.1 (K), R8.1
unnamed: LD2.1 (K), R9.1
unnamed: Q1.2 (B), R7.2
unnamed: R7.1, U3.3 (Q)
unnamed: R10.1, R12.2, U1.1 (ADJ)
unnamed: R11.1, R13.2, U2.1 (ADJ)
VDC: BR1.1 (+), C1.1, C2.1, C3.1, C4.1, C5.1, D1.1 (K), Q2.2 (A), U1.3 (VI)

Notes on the sheet:
Heatsink shared between D2, U1 and U2. U1 or U2 needs to be isolated!
Notes: - LD1, LD2 necessary to meet minimum load requirement of U1 and U2. - Thyristor crowbar is triggered at approx. 12.7V and 5,4V respectively. - U3 switches K1 after approx. 5s.
Fuck-ups: -Circuit starts with relais energized. Fix: Replace Q1 with PNP -Pads for NTC too small

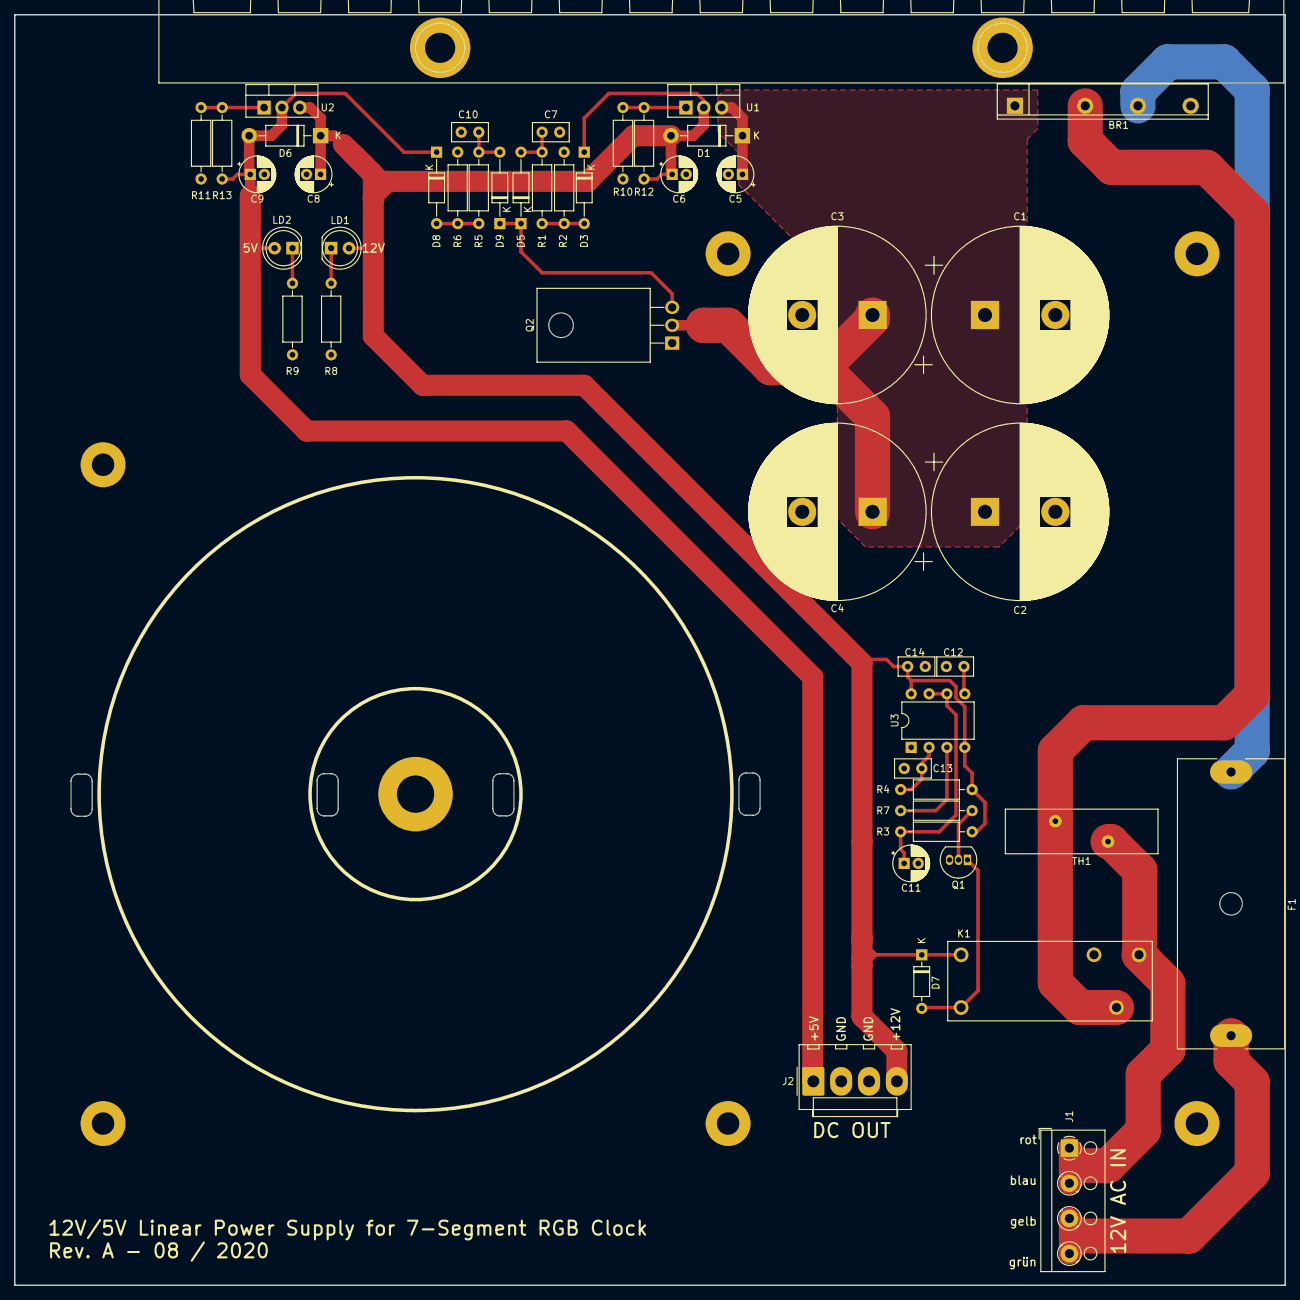
[picture p11: board Power supply.kicad_pcb from above]

Board: 2 copper layers, 180.7 x 180.7 mm, 58 parts (0 on the bottom side), 23 nets.
