kuellenberg/7-Segment-RGB-Clock/Digit_Colon/Digit_Colon.kicad_pcb

## KiCad design Digit_Colon/Digit_Colon.kicad_pcb (2019-10-04)

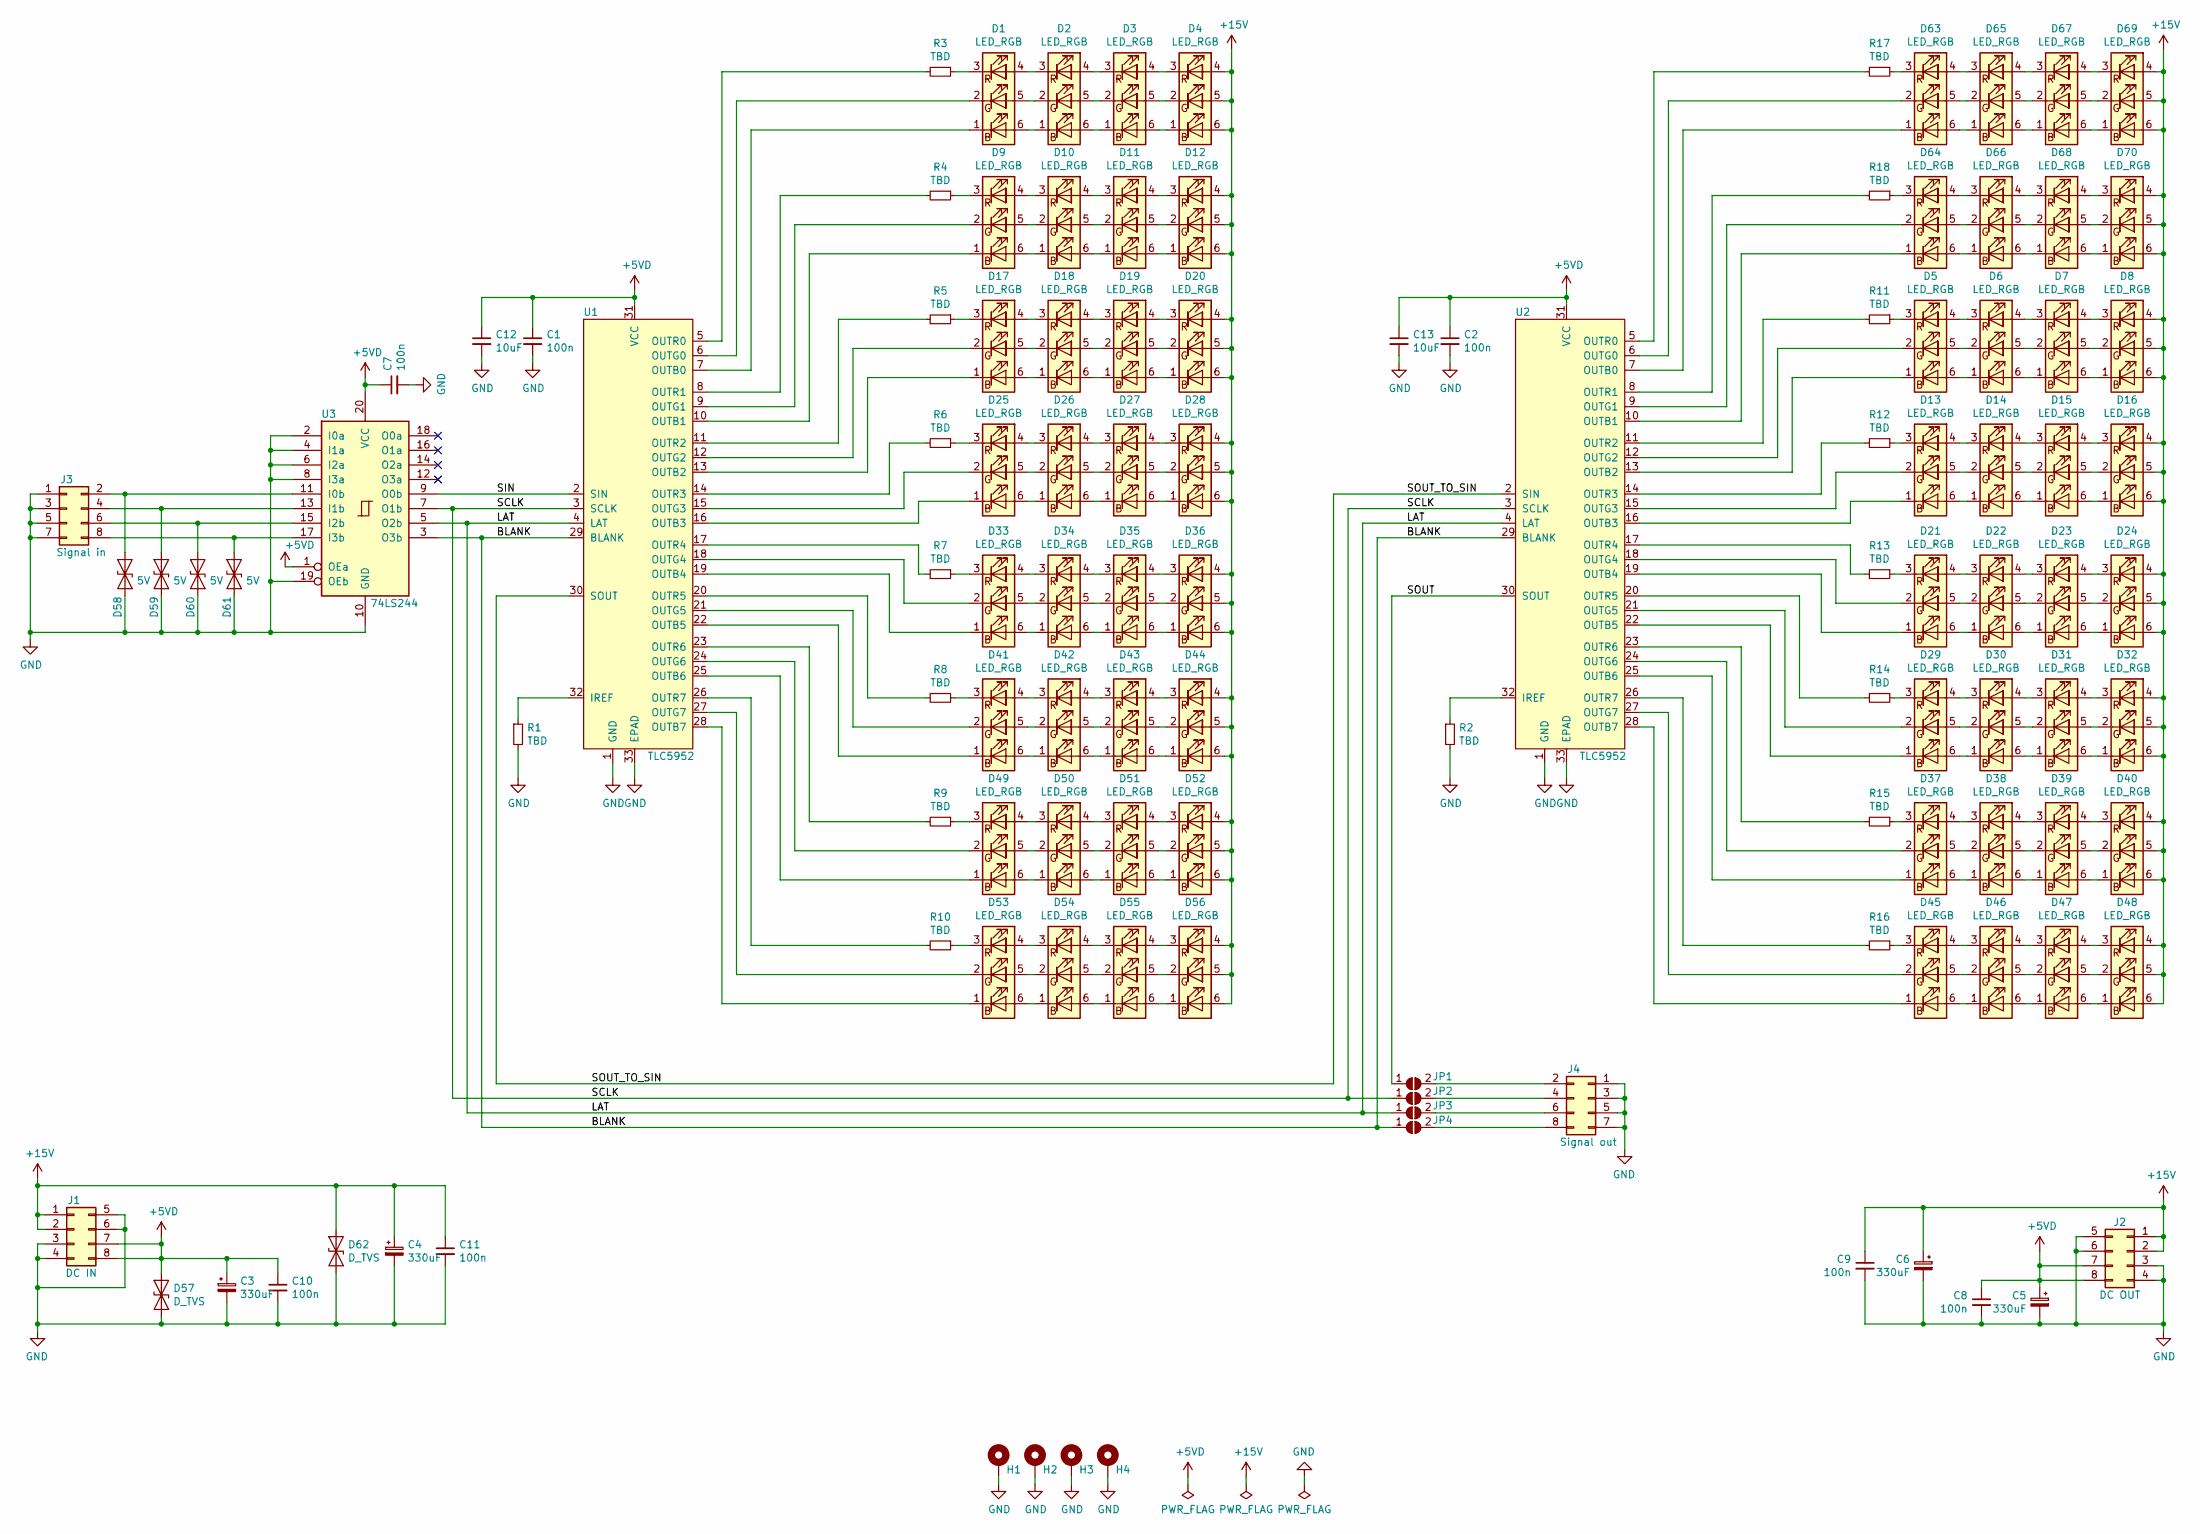
[picture p12: schematic Digit_Colon.sch]

Parts:
C1, C2, C7, C8, C9, C10, C11: 100n; C_0805_2012Metric
C3, C4, C5, C6: 330uF; C_Elec_8x10.2
C12, C13: 10uF; C_0805_2012Metric
D1, D2, D3, D4, D5, D6, D7, D8, D9, D10, D11, D12, D13, D14, D15, D16, D17, D18, D19, D20, D21, D22, D23, D24, D25, D26, D27, D28, D29, D30, D31, D32, D33, D34, D35, D36, D37, D38, D39, D40, D41, D42, D43, D44, D45, D46, D47, D48, D49, D50, D51, D52, D53, D54, D55, D56, D63, D64, D65, D66, D67, D68, D69, D70: LED_RGB; LED_RGB_5050-6
D57, D62: D_TVS; D_SMA
D58, D59, D60, D61: 5V; D_SOD-323
H1, H2, H3, H4: MountingHole_Pad; MountingHole_3.2mm_M3_Pad_Via
J1: DC IN; HARWIN_M20-8890845
J2: DC OUT; HARWIN_M20-7910842R
J3: Signal in; HARWIN_M20-7910842R
J4: Signal out; HARWIN_M20-8890845
JP1, JP2, JP3, JP4: SolderJumper_2_Open; SolderJumper-2_P1.3mm_Open_TrianglePad1.0x1.5mm
R1, R2, R3, R4, R5, R6, R7, R8, R9, R10, R11, R12, R13, R14, R15, R16, R17, R18: TBD; R_0805_2012Metric
U1, U2: TLC5952; HTSSOP-32-1EP_6.1x11mm_P0.65mm_EP5.2x11mm_Mask4.11x4.36mm_T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
U3: 74LS244; SO-20_12.8x7.5mm_P1.27mm

Connections:
+5VD: C1.1, C2.1, C3.1, C5.1, C7.1, C8.1, C10.1, C12.1, C13.1, D57.1 (A1), J1.7, J1.8, J2.7, J2.8, U1.31 (VCC), U2.31 (VCC), U3.1 (OEa), U3.20 (VCC)
+15V: C4.1, C6.1, C9.1, C11.1, D4.4 (RA), D4.5 (GA), D4.6 (BA), D8.4 (RA), D8.5 (GA), D8.6 (BA), D12.4 (RA), D12.5 (GA), D12.6 (BA), D16.4 (RA), D16.5 (GA), D16.6 (BA), D20.4 (RA), D20.5 (GA), D20.6 (BA), D24.4 (RA), D24.5 (GA), D24.6 (BA), D28.4 (RA), D28.5 (GA), D28.6 (BA), D32.4 (RA), D32.5 (GA), D32.6 (BA), D36.4 (RA), D36.5 (GA), D36.6 (BA), D40.4 (RA), D40.5 (GA), D40.6 (BA), D44.4 (RA), D44.5 (GA), D44.6 (BA), D48.4 (RA), D48.5 (GA), D48.6 (BA), D52.4 (RA), D52.5 (GA), D52.6 (BA), D56.4 (RA), D56.5 (GA), D56.6 (BA), D62.1 (A1), D69.4 (RA), D69.5 (GA), D69.6 (BA), D70.4 (RA), D70.5 (GA), D70.6 (BA), J1.1, J1.2, J2.1, J2.2
/BLANK: JP4.1 (A), U1.29 (BLANK), U2.29 (BLANK), U3.3 (O3b)
/LAT: JP3.1 (A), U1.4 (LAT), U2.4 (LAT), U3.5 (O2b)
/SCLK: JP2.1 (A), U1.3 (SCLK), U2.3 (SCLK), U3.7 (O1b)
/SIN: U1.2 (SIN), U3.9 (O0b)
/SOUT: JP1.1 (A), U2.30 (SOUT)
/SOUT_TO_SIN: U1.30 (SOUT), U2.2 (SIN)
GND: C1.2, C2.2, C3.2, C4.2, C5.2, C6.2, C7.2, C8.2, C9.2, C10.2, C11.2, C12.2, C13.2, D57.2 (A2), D58.2 (A2), D59.2 (A2), D60.2 (A2), D61.2 (A2), D62.2 (A2), H1.1, H2.1, H3.1, H4.1, J1.3, J1.4, J1.5, J1.6, J2.3, J2.4, J2.5, J2.6, J3.1, J3.3, J3.5, J3.7, J4.1, J4.3, J4.5, J4.7, R1.2, R2.2, U1.1 (GND), U1.33 (EPAD), U2.1 (GND), U2.33 (EPAD), U3.2 (I0a), U3.4 (I1a), U3.6 (I2a), U3.8 (I3a), U3.10 (GND), U3.19 (OEb)
unnamed: D1.1 (BK), U1.7 (OUTB0)
unnamed: D1.2 (GK), U1.6 (OUTG0)
unnamed: D1.3 (RK), R3.1
unnamed: D1.4 (RA), D2.3 (RK)
unnamed: D1.5 (GA), D2.2 (GK)
unnamed: D1.6 (BA), D2.1 (BK)
unnamed: D2.4 (RA), D3.3 (RK)
unnamed: D2.5 (GA), D3.2 (GK)
unnamed: D2.6 (BA), D3.1 (BK)
unnamed: D3.4 (RA), D4.3 (RK)
unnamed: D3.5 (GA), D4.2 (GK)
unnamed: D3.6 (BA), D4.1 (BK)
unnamed: D5.1 (BK), U2.13 (OUTB2)
unnamed: D5.2 (GK), U2.12 (OUTG2)
unnamed: D5.3 (RK), R11.1
unnamed: D5.4 (RA), D6.3 (RK)
unnamed: D5.5 (GA), D6.2 (GK)
unnamed: D5.6 (BA), D6.1 (BK)
unnamed: D6.4 (RA), D7.3 (RK)
unnamed: D6.5 (GA), D7.2 (GK)
unnamed: D6.6 (BA), D7.1 (BK)
unnamed: D7.4 (RA), D8.3 (RK)
unnamed: D7.5 (GA), D8.2 (GK)
unnamed: D7.6 (BA), D8.1 (BK)
unnamed: D9.1 (BK), U1.10 (OUTB1)
unnamed: D9.2 (GK), U1.9 (OUTG1)
unnamed: D9.3 (RK), R4.1
unnamed: D9.6 (BA), D10.1 (BK)
unnamed: D9.5 (GA), D10.2 (GK)
unnamed: D9.4 (RA), D10.3 (RK)
unnamed: D10.4 (RA), D11.3 (RK)
unnamed: D10.5 (GA), D11.2 (GK)
unnamed: D10.6 (BA), D11.1 (BK)
unnamed: D11.4 (RA), D12.3 (RK)
unnamed: D11.5 (GA), D12.2 (GK)
unnamed: D11.6 (BA), D12.1 (BK)
unnamed: D13.1 (BK), U2.16 (OUTB3)
unnamed: D13.2 (GK), U2.15 (OUTG3)
unnamed: D13.3 (RK), R12.1
unnamed: D13.4 (RA), D14.3 (RK)
unnamed: D13.5 (GA), D14.2 (GK)
unnamed: D13.6 (BA), D14.1 (BK)
unnamed: D14.4 (RA), D15.3 (RK)
unnamed: D14.5 (GA), D15.2 (GK)
unnamed: D14.6 (BA), D15.1 (BK)
unnamed: D15.4 (RA), D16.3 (RK)
unnamed: D15.5 (GA), D16.2 (GK)
unnamed: D15.6 (BA), D16.1 (BK)
unnamed: D17.1 (BK), U1.13 (OUTB2)
unnamed: D17.2 (GK), U1.12 (OUTG2)
unnamed: D17.3 (RK), R5.1
unnamed: D17.4 (RA), D18.3 (RK)
unnamed: D17.5 (GA), D18.2 (GK)
unnamed: D17.6 (BA), D18.1 (BK)
unnamed: D18.4 (RA), D19.3 (RK)
unnamed: D18.5 (GA), D19.2 (GK)
unnamed: D18.6 (BA), D19.1 (BK)
unnamed: D19.4 (RA), D20.3 (RK)
unnamed: D19.5 (GA), D20.2 (GK)
unnamed: D19.6 (BA), D20.1 (BK)
unnamed: D21.1 (BK), U2.19 (OUTB4)
unnamed: D21.2 (GK), U2.18 (OUTG4)
unnamed: D21.3 (RK), R13.1
unnamed: D21.4 (RA), D22.3 (RK)
unnamed: D21.5 (GA), D22.2 (GK)
unnamed: D21.6 (BA), D22.1 (BK)
unnamed: D22.4 (RA), D23.3 (RK)
unnamed: D22.5 (GA), D23.2 (GK)
unnamed: D22.6 (BA), D23.1 (BK)
unnamed: D23.4 (RA), D24.3 (RK)
unnamed: D23.5 (GA), D24.2 (GK)
unnamed: D23.6 (BA), D24.1 (BK)
unnamed: D25.1 (BK), U1.16 (OUTB3)
unnamed: D25.2 (GK), U1.15 (OUTG3)
unnamed: D25.3 (RK), R6.1
unnamed: D25.4 (RA), D26.3 (RK)
unnamed: D25.5 (GA), D26.2 (GK)
unnamed: D25.6 (BA), D26.1 (BK)
unnamed: D26.4 (RA), D27.3 (RK)
unnamed: D26.5 (GA), D27.2 (GK)
unnamed: D26.6 (BA), D27.1 (BK)
unnamed: D27.4 (RA), D28.3 (RK)
unnamed: D27.5 (GA), D28.2 (GK)
unnamed: D27.6 (BA), D28.1 (BK)
unnamed: D29.1 (BK), U2.22 (OUTB5)
unnamed: D29.2 (GK), U2.21 (OUTG5)
unnamed: D29.3 (RK), R14.1
unnamed: D29.4 (RA), D30.3 (RK)
unnamed: D29.5 (GA), D30.2 (GK)
unnamed: D29.6 (BA), D30.1 (BK)
unnamed: D30.4 (RA), D31.3 (RK)
unnamed: D30.5 (GA), D31.2 (GK)
unnamed: D30.6 (BA), D31.1 (BK)
unnamed: D31.4 (RA), D32.3 (RK)
unnamed: D31.5 (GA), D32.2 (GK)
unnamed: D31.6 (BA), D32.1 (BK)
unnamed: D33.1 (BK), U1.19 (OUTB4)
unnamed: D33.2 (GK), U1.18 (OUTG4)
unnamed: D33.3 (RK), R7.1
unnamed: D33.4 (RA), D34.3 (RK)
unnamed: D33.5 (GA), D34.2 (GK)
unnamed: D33.6 (BA), D34.1 (BK)
unnamed: D34.4 (RA), D35.3 (RK)
unnamed: D34.5 (GA), D35.2 (GK)
unnamed: D34.6 (BA), D35.1 (BK)
unnamed: D35.4 (RA), D36.3 (RK)
unnamed: D35.5 (GA), D36.2 (GK)
unnamed: D35.6 (BA), D36.1 (BK)
unnamed: D37.1 (BK), U2.25 (OUTB6)
unnamed: D37.2 (GK), U2.24 (OUTG6)
unnamed: D37.3 (RK), R15.1
unnamed: D37.4 (RA), D38.3 (RK)
unnamed: D37.5 (GA), D38.2 (GK)
unnamed: D37.6 (BA), D38.1 (BK)
unnamed: D38.4 (RA), D39.3 (RK)
unnamed: D38.5 (GA), D39.2 (GK)
unnamed: D38.6 (BA), D39.1 (BK)
unnamed: D39.4 (RA), D40.3 (RK)
unnamed: D39.5 (GA), D40.2 (GK)
unnamed: D39.6 (BA), D40.1 (BK)
unnamed: D41.1 (BK), U1.22 (OUTB5)
unnamed: D41.2 (GK), U1.21 (OUTG5)
unnamed: D41.3 (RK), R8.1
unnamed: D41.4 (RA), D42.3 (RK)
unnamed: D41.5 (GA), D42.2 (GK)
unnamed: D41.6 (BA), D42.1 (BK)
unnamed: D42.4 (RA), D43.3 (RK)
unnamed: D42.5 (GA), D43.2 (GK)
unnamed: D42.6 (BA), D43.1 (BK)
unnamed: D43.4 (RA), D44.3 (RK)
unnamed: D43.5 (GA), D44.2 (GK)
unnamed: D43.6 (BA), D44.1 (BK)
unnamed: D45.1 (BK), U2.28 (OUTB7)
unnamed: D45.2 (GK), U2.27 (OUTG7)
unnamed: D45.3 (RK), R16.1
unnamed: D45.4 (RA), D46.3 (RK)
unnamed: D45.5 (GA), D46.2 (GK)
unnamed: D45.6 (BA), D46.1 (BK)
unnamed: D46.4 (RA), D47.3 (RK)
unnamed: D46.5 (GA), D47.2 (GK)
unnamed: D46.6 (BA), D47.1 (BK)
unnamed: D47.4 (RA), D48.3 (RK)
unnamed: D47.5 (GA), D48.2 (GK)
unnamed: D47.6 (BA), D48.1 (BK)
unnamed: D49.1 (BK), U1.25 (OUTB6)
unnamed: D49.2 (GK), U1.24 (OUTG6)
unnamed: D49.3 (RK), R9.1
unnamed: D49.4 (RA), D50.3 (RK)
unnamed: D49.5 (GA), D50.2 (GK)
unnamed: D49.6 (BA), D50.1 (BK)
unnamed: D50.4 (RA), D51.3 (RK)
unnamed: D50.5 (GA), D51.2 (GK)
unnamed: D50.6 (BA), D51.1 (BK)
unnamed: D51.4 (RA), D52.3 (RK)
unnamed: D51.5 (GA), D52.2 (GK)
unnamed: D51.6 (BA), D52.1 (BK)
unnamed: D53.1 (BK), U1.28 (OUTB7)
unnamed: D53.2 (GK), U1.27 (OUTG7)
unnamed: D53.3 (RK), R10.1
unnamed: D53.4 (RA), D54.3 (RK)
unnamed: D53.5 (GA), D54.2 (GK)
unnamed: D53.6 (BA), D54.1 (BK)
unnamed: D54.4 (RA), D55.3 (RK)
unnamed: D54.5 (GA), D55.2 (GK)
unnamed: D54.6 (BA), D55.1 (BK)
unnamed: D55.4 (RA), D56.3 (RK)
unnamed: D55.5 (GA), D56.2 (GK)
unnamed: D55.6 (BA), D56.1 (BK)
unnamed: D58.1 (A1), J3.2, U3.11 (I0b)
unnamed: D59.1 (A1), J3.4, U3.13 (I1b)
unnamed: D60.1 (A1), J3.6, U3.15 (I2b)
unnamed: D61.1 (A1), J3.8, U3.17 (I3b)
unnamed: D63.1 (BK), U2.7 (OUTB0)
unnamed: D63.2 (GK), U2.6 (OUTG0)
unnamed: D63.3 (RK), R17.1
unnamed: D63.4 (RA), D65.3 (RK)
unnamed: D63.5 (GA), D65.2 (GK)
unnamed: D63.6 (BA), D65.1 (BK)
unnamed: D64.1 (BK), U2.10 (OUTB1)
unnamed: D64.2 (GK), U2.9 (OUTG1)
unnamed: D64.3 (RK), R18.1
unnamed: D64.4 (RA), D66.3 (RK)
unnamed: D64.5 (GA), D66.2 (GK)
unnamed: D64.6 (BA), D66.1 (BK)
unnamed: D65.4 (RA), D67.3 (RK)
unnamed: D65.5 (GA), D67.2 (GK)
unnamed: D65.6 (BA), D67.1 (BK)
unnamed: D66.4 (RA), D68.3 (RK)
unnamed: D66.5 (GA), D68.2 (GK)
unnamed: D66.6 (BA), D68.1 (BK)
unnamed: D67.4 (RA), D69.3 (RK)
unnamed: D67.5 (GA), D69.2 (GK)
unnamed: D67.6 (BA), D69.1 (BK)
unnamed: D68.4 (RA), D70.3 (RK)
unnamed: D68.5 (GA), D70.2 (GK)
unnamed: D68.6 (BA), D70.1 (BK)
unnamed: J4.2, JP1.2 (B)
unnamed: J4.4, JP2.2 (B)
unnamed: J4.6, JP3.2 (B)
unnamed: J4.8, JP4.2 (B)
unnamed: R1.1, U1.32 (IREF)
unnamed: R2.1, U2.32 (IREF)
unnamed: R3.2, U1.5 (OUTR0)
unnamed: R4.2, U1.8 (OUTR1)
unnamed: R5.2, U1.11 (OUTR2)
unnamed: R6.2, U1.14 (OUTR3)
unnamed: R7.2, U1.17 (OUTR4)
unnamed: R8.2, U1.20 (OUTR5)
unnamed: R9.2, U1.23 (OUTR6)
unnamed: R10.2, U1.26 (OUTR7)
unnamed: R11.2, U2.11 (OUTR2)
unnamed: R12.2, U2.14 (OUTR3)
unnamed: R13.2, U2.17 (OUTR4)
unnamed: R14.2, U2.20 (OUTR5)
unnamed: R15.2, U2.23 (OUTR6)
unnamed: R16.2, U2.26 (OUTR7)
unnamed: R17.2, U2.5 (OUTR0)
unnamed: R18.2, U2.8 (OUTR1)
