kuellenberg/7-Segment-RGB-Clock/Digit_Colon/Digit_Colon.kicad_pcb

## KiCad design Digit_Colon/Digit_Colon.kicad_pcb (continued)

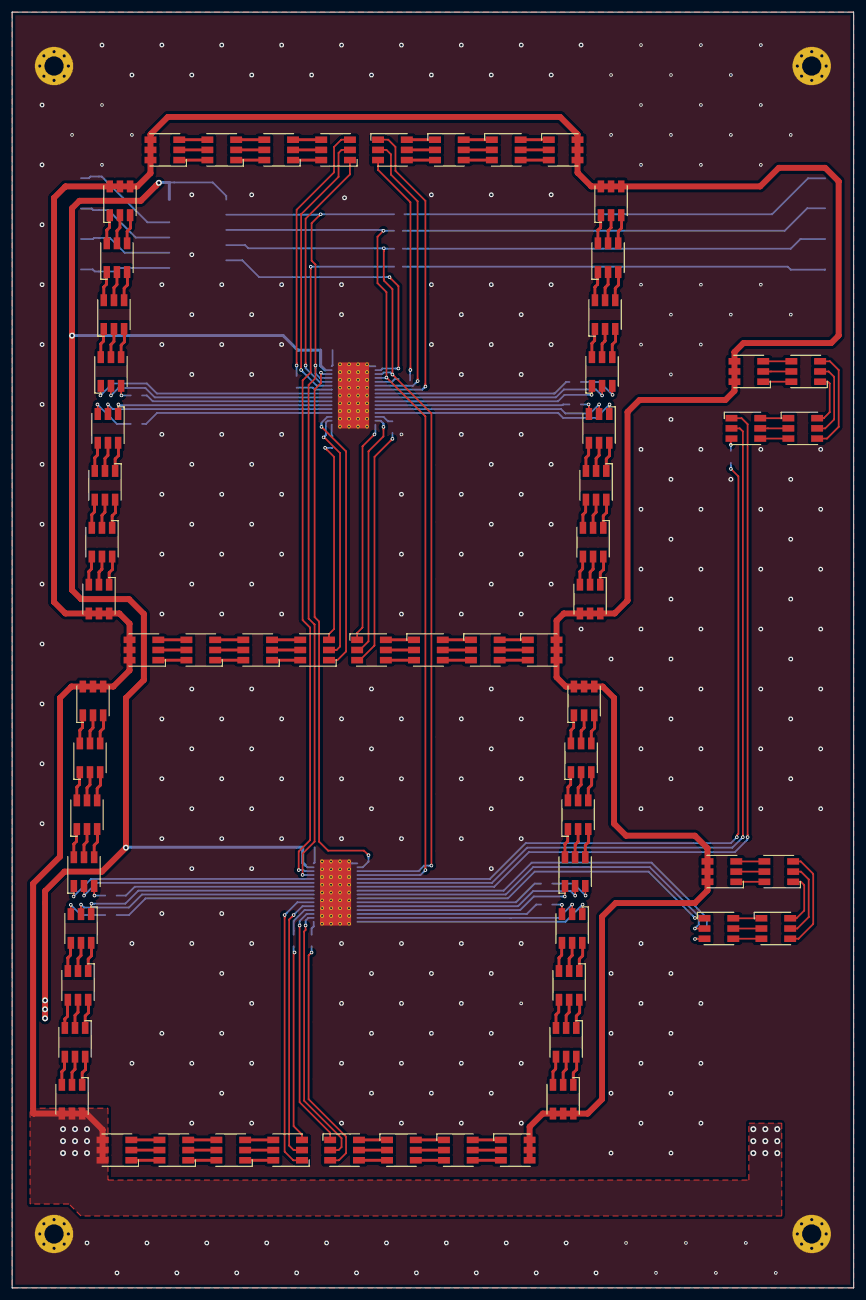
[picture p13: board Digit_Colon.kicad_pcb from above]

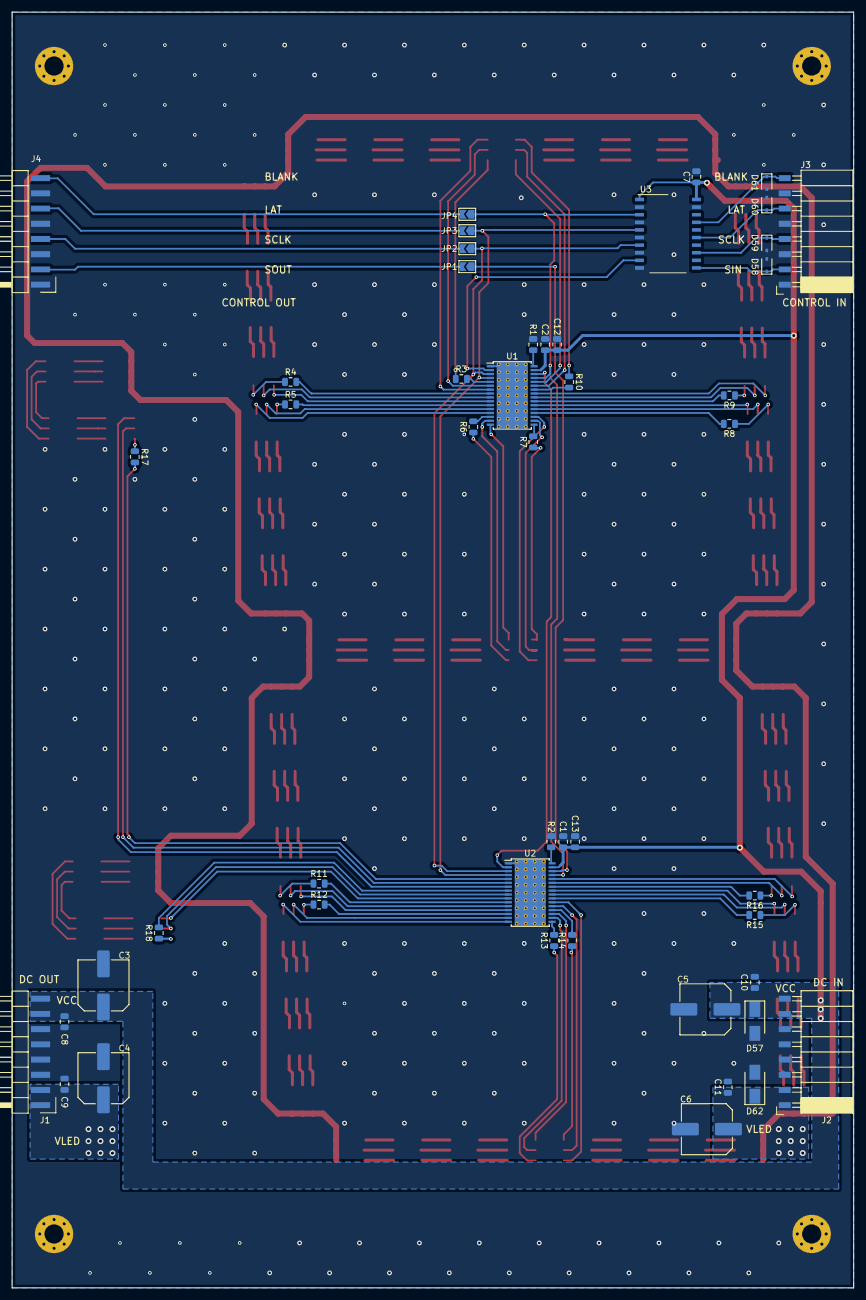
[picture p14: board Digit_Colon.kicad_pcb from below]

Board: 2 copper layers, 140.5 x 213.0 mm, 116 parts (48 on the bottom side), 227 nets.
