kuellenberg/7-Segment-RGB-Clock/(commit log)

2019-09-16 all change...
    [Fancy-7-Segment-LED-Clock.kicad_pcb, Fancy-7-Segment-LED-Clock.sch]
2019-09-19 Added line driver. Routing.
    [Fancy-7-Segment-LED-Clock.kicad_pcb, Fancy-7-Segment-LED-Clock.sch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]
2019-09-20 Routing. Via stitching
    [Fancy-7-Segment-LED-Clock.kicad_pcb]
2019-09-20 Moved PCB and origin.
    [Fancy-7-Segment-LED-Clock.kicad_pcb]
2019-09-20 Square PCB
    [Fancy-7-Segment-LED-Clock.kicad_pcb]
2019-09-20 Finished routing. Added text.
    [Fancy-7-Segment-LED-Clock.kicad_pcb, Fancy-7-Segment-LED-Clock.sch]
2019-09-21 Created digit with colon
    [Digit+Colon.kicad_pcb, Digit+Colon.sch, Single Digit.kicad_pcb, Single Digit.sch, Ziffern.kicad_pcb, gross-kursiv1.kicad_pcb, gross-kursiv2.kicad_pcb, gross-kursiv2b.kicad_pcb]
2019-09-24 Added controller schematic
    [Controller.kicad_pcb, Controller.sch, Kopie von Arduino Nano 3.1 BOM.xlsx]
2019-09-25 Controller schematic...
    [Arduino Nano 3.1 BOM.xlsx, Controller.sch]
2019-10-01 Ground vias digit+colon. Placement/routing controller
    [Controller.kicad_pcb, Controller.sch, Digit_Colon.kicad_pcb]
2019-10-02 Routing controller
    [Controller.kicad_pcb, Controller.sch]
2019-10-04 Finished routing controller pcb.
    [Controller.kicad_pcb]
2019-10-04 Created mounting bracket.
    [Bracket.kicad_pcb, Bracket.sch, Controller.sch]
2019-10-04 Minor changes. BOM
    [BOM.xlsx, Digit.kicad_pcb, Digit.sch, Digit_Colon.kicad_pcb, Digit_Colon.sch]
2019-10-04 Moved mounting holes. Moved stuff around on controller PCB.
    [Bracket.kicad_pcb, Bracket.step, Controller.kicad_pcb, Controller.sch, Digit.kicad_pcb, Digit_Colon.kicad_pcb]
2019-10-05 Modified controller layout. Fixed distance to board edge.
    [Controller.kicad_pcb]
2019-10-29 minor layout change.
    [Controller.kicad_pcb]
2019-12-11 Bug fixes: * Reset circuit - netlabel RESET -> /RESET - Reset button pulls high - FTDI DTR connected to reset line * Added pull-ups to RTC outputs * Moved status LED to PC1 TODO: * Add thermal relief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
    [Controller.kicad_pcb, Controller.sch]
2020-03-19 Replaced LDR with PD, changed USB connector.
    [Bracket-B_Cu.gbr, Bracket-B_Mask.gbr, Bracket-B_Paste.gbr, Bracket-B_SilkS.gbr, Bracket-Edge_Cuts.gbr, Bracket-F_Cu.gbr, Bracket-F_Mask.gbr, Bracket-F_Paste.gbr]
2020-03-20 Layout updated
    [Controller.kicad_pcb]
2020-03-28 shortened pcb by 1mm
    [Controller.kicad_pcb, Controller.sch]
2020-05-12 Replaced 15V connector. Created BOM and Gerbers
    [Controller-B_Cu.gbr, Controller-B_Mask.gbr, Controller-B_Paste.gbr, Controller-B_SilkS.gbr, Controller-Edge_Cuts.gbr, Controller-F_Cu.gbr, Controller-F_Mask.gbr, Controller-F_Paste.gbr]
2020-05-13 BOM update
    [Controller.sch]
2020-06-01 Power Supply
    [Power supply.kicad_pcb, Power supply.sch]
2020-06-10 add BOM for RS Components
    [RS Components.xls]
2020-07-15 PCB outline
    [platine.dxf]
2020-07-31 Assembly drawing
    [Controller.kicad_pcb, RS Components.xls]
2020-08-10 BOM Controller
    [BOM Controller.ods]
2021-01-03 about to merge
    [BOM - Rev. A.xlsx, Controller.kicad_pcb, Controller.sch]
2021-02-08 Minor changes
    [Controller.sch, Digit.sch, Digit_Colon.sch]
